usevolt/esb/doc/ce_mark.pdf

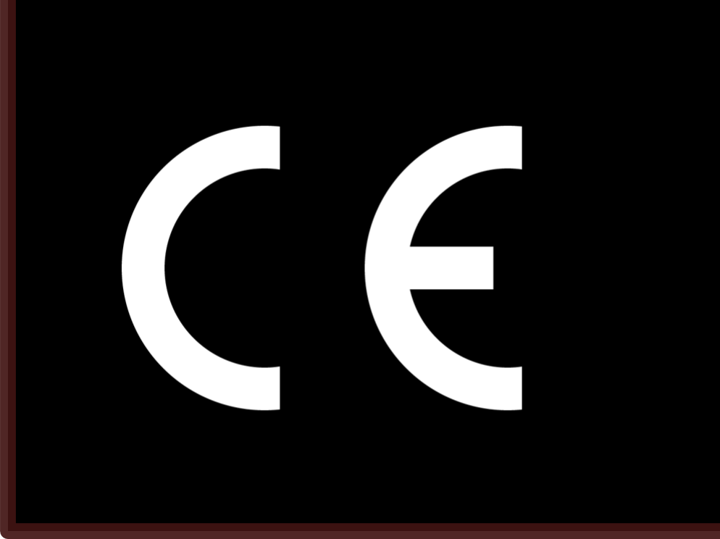
[picture p1: figure]
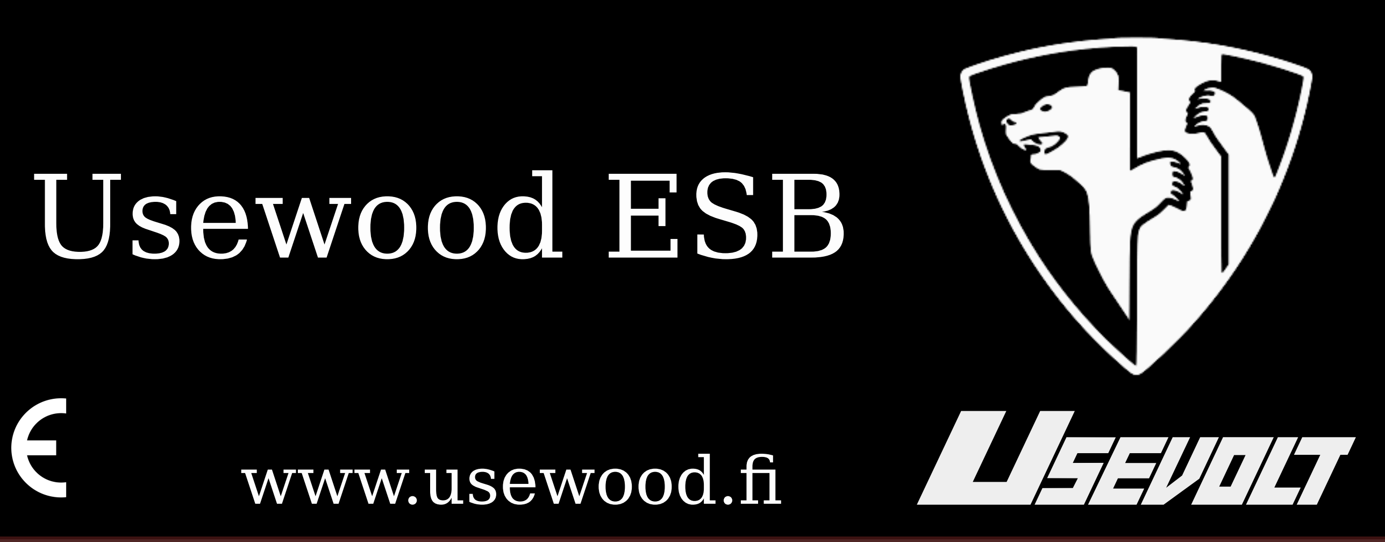
[picture p2: figure]
www.usewood.fi; Usewood ESB
