usevolt/esb/doc/ce_mark_esb_55x20mm.png

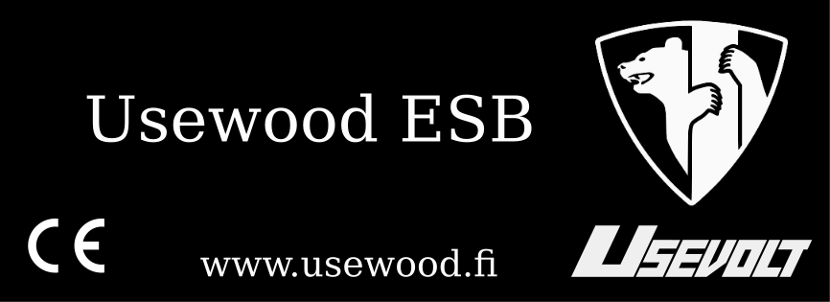
doc/ce_mark_esb_55x20mm.png
