usevolt/esb/hw/esb.FCStd

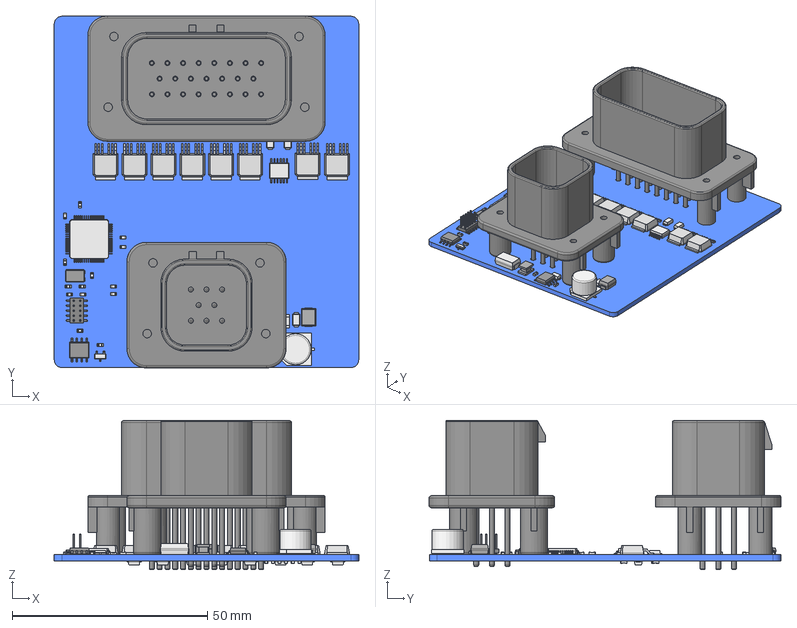
[picture p4: CAD file, 2018-08-07]
hw/esb.FCStd
78.0 x 90.2 x 38.2 mm
Pcb
