usevolt/esb/doc/EDC17CV41_MARINE_C16_CAN_Spec_Feb_2020.pdf

## MARINE

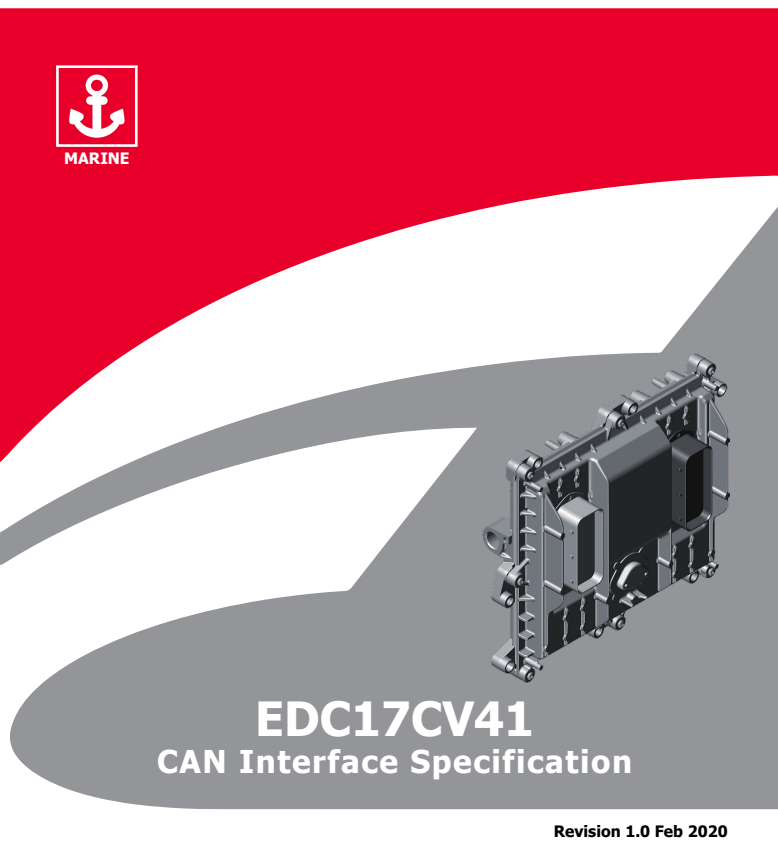
[picture p13: page 1]
Revision 1.0 Feb 2020

EDC17CV41
CAN Interface Specification

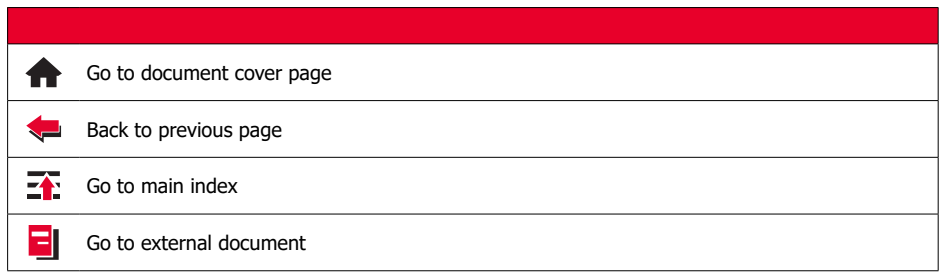
[picture p14: figure]
Go to document cover page; Back to previous page; Go to main index; Go to external document

All Rights Reserved
FPT Confidential and Proprietary Controlled copy is located on fptindustrial.com

B CAN Interface Specification

EDC17CV41
Revision 1.0 Feb 2020

## REVISION HISTORY Document updating

Modification description | Date
First release | Feb 2020

## FPT internal document reference Revision 2.2

Rev | Date | Description | Authors | Approval
2.2 | 11/12/2019 | Modified Document Name EAC Auxiliary/ water system pressure added for C16 | M. Brunello | A. Mazzurco

## INTRODUCTION

## Symbols Reference

## Legend

Signals compliant with SAE which are “not used” or “not evaluated”. Signals in the proprietary messages which are “not used” or “not evaluated”.
“h” hexadecimal values.
“b” binary values.
NB: Value of signals in the messages that are “not used” or “not evaluated” could be not specified.

## REFERENCES

All data is subject to change without notice.

## INDEX

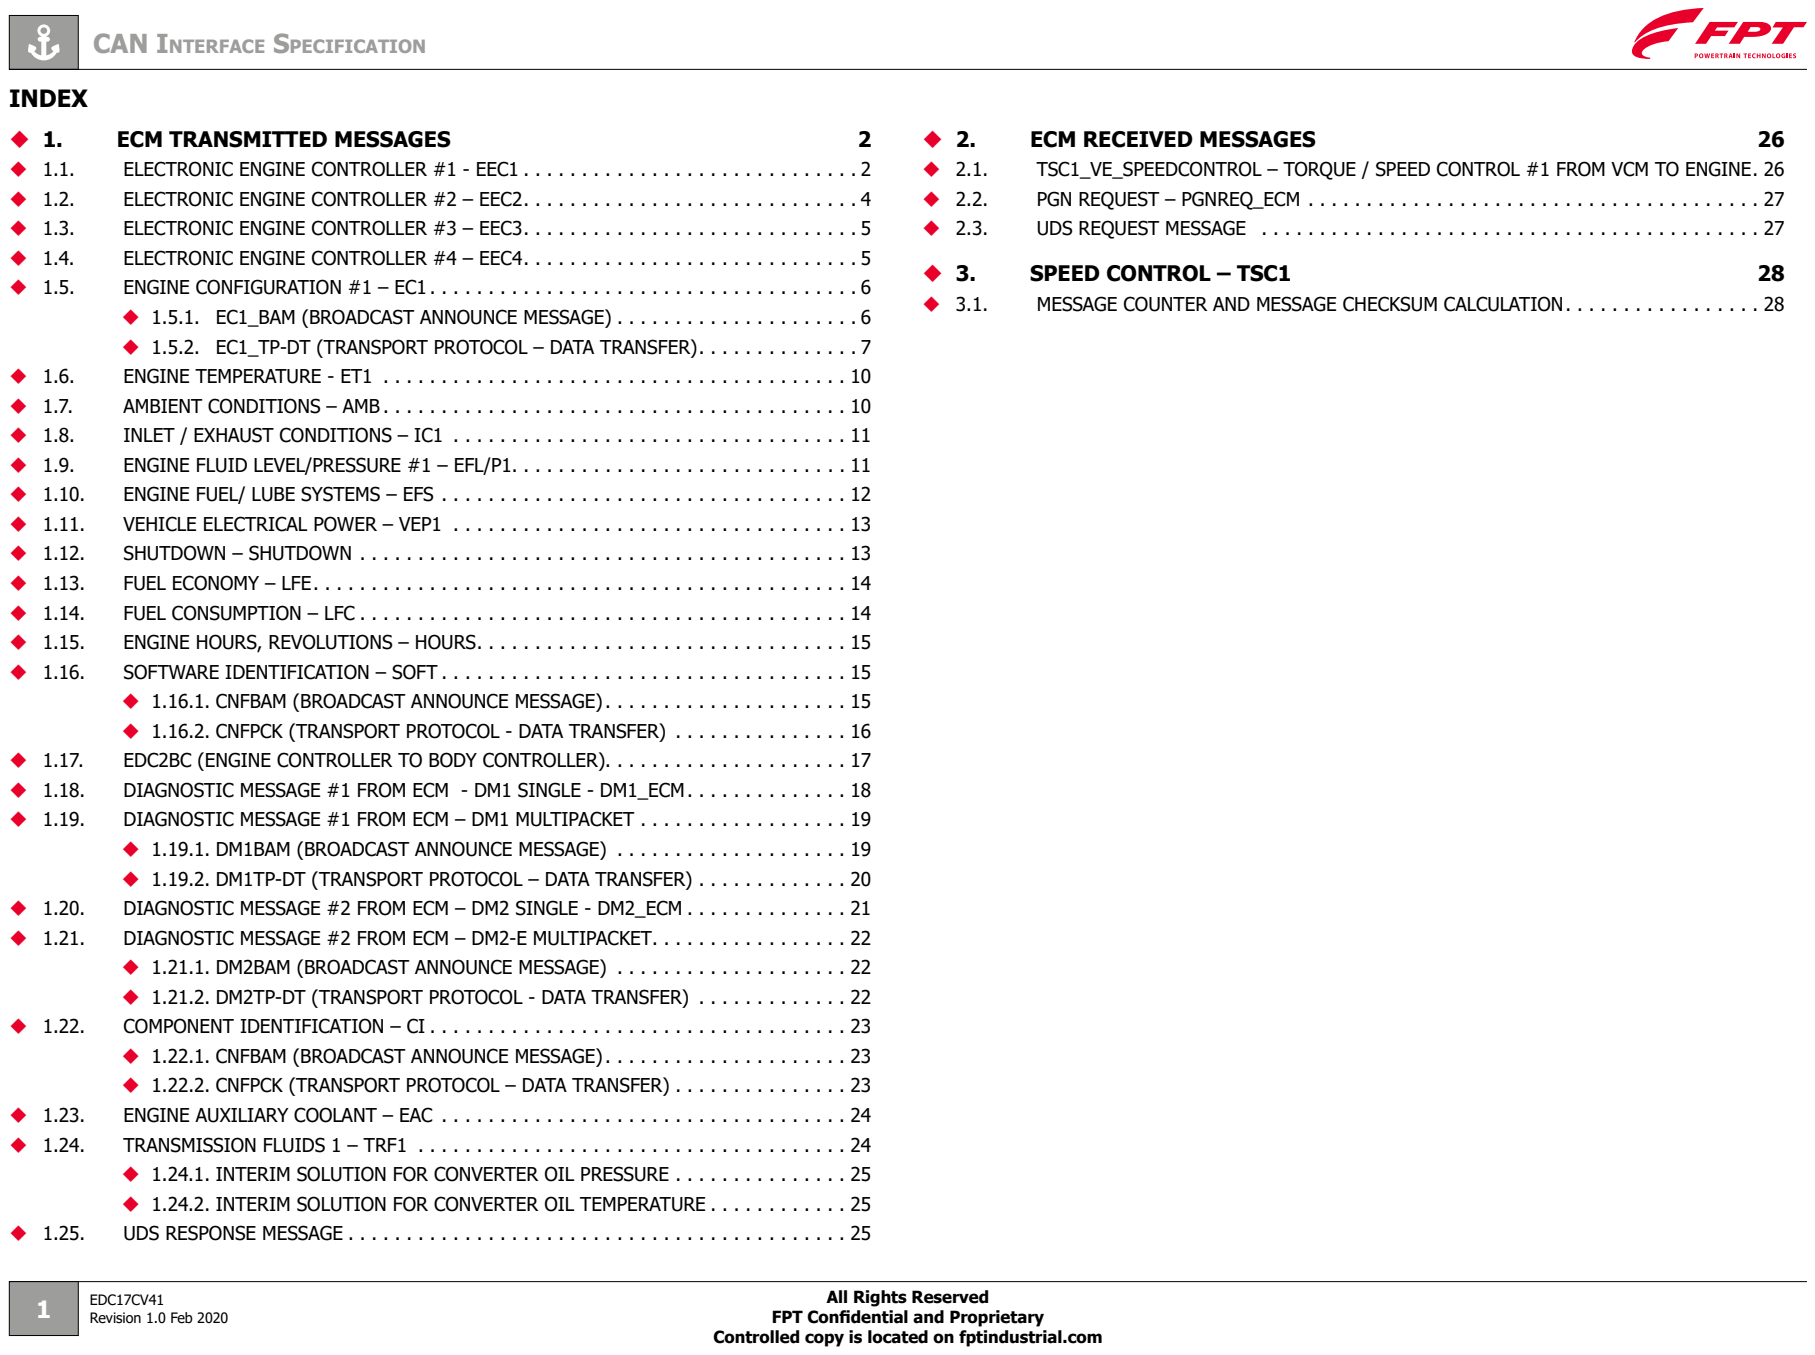
[picture p15: page 3]
ECM TRANSMITTED MESSAGES; ECM RECEIVED MESSAGES; TSC1_VE_SPEEDCONTROL – TORQUE / SPEED CONTROL #1 FROM VCM TO ENGINE.; SPEED CONTROL – TSC1

CAN Interface Specification

## 1. ECM TRANSMITTED MESSAGES

## 1.1. Electronic Engine Controller #1 - EEC1

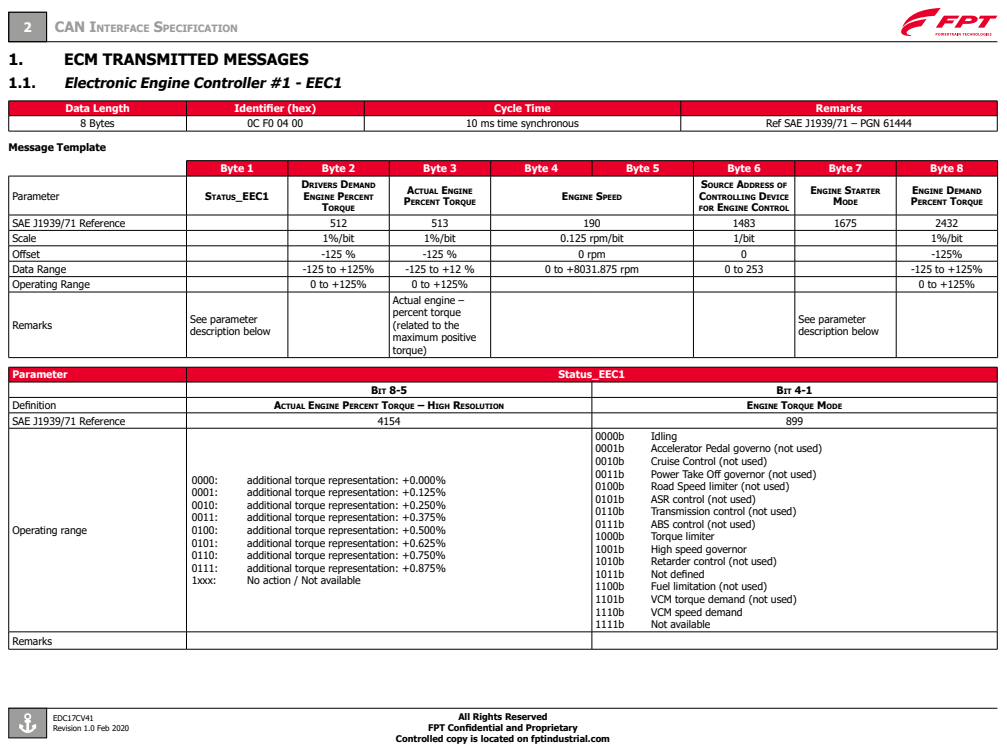
[picture p16: page 4]
Message Template

2 CAN Interface Specification

Data Length | Identifier (hex) | Cycle Time | Remarks
8 Bytes | 0C F0 04 00 | 10 ms time synchronous | Ref SAE J1939/71 – PGN 61444

Byte 1 | Byte 2 | Byte 3 | Byte 4 | Byte 5 | Byte 6 | Byte 7 | Byte 8

Parameter | Status_EEC1 | Drivers Demand Engine Percent Torque | Actual Engine Percent Torque | Engine Speed | Source Address of Controlling Device for Engine Control | Engine Starter Mode | Engine Demand Percent Torque

SAE J1939/71 Reference | | 512 | 513 | 190 | 1483 | 1675 | 2432
Scale | | 1%/bit | 1%/bit | 0.125 rpm/bit | 1/bit | | 1%/bit
Offset | | -125 % | -125 % | 0 rpm | 0 | | -125%
Data Range | | -125 to +125% | -125 to +12 % | 0 to +8031.875 rpm | 0 to 253 | | -125 to +125%
Operating Range | | 0 to +125% | 0 to +125% | | | | 0 to +125%
Remarks | See parameter description below | | Actual engine – percent torque (related to the maximum positive torque) | | | See parameter description below

Parameter | Status_EEC1

Bit 8-5 | Bit 4-1

Definition | Actual Engine Percent Torque – High Resolution | Engine Torque Mode
SAE J1939/71 Reference | 4154 | 899
Operating range | 0000: additional torque representation: +0.000% 0001: additional torque representation: +0.125% 0010: additional torque representation: +0.250% 0011: additional torque representation: +0.375% 0100: additional torque representation: +0.500% 0101: additional torque representation: +0.625% 0110: additional torque representation: +0.750% 0111: additional torque representation: +0.875% 1xxx: No action / Not available | 0000b Idling 0001b Accelerator Pedal governo (not used) 0010b Cruise Control (not used) 0011b Power Take Off governor (not used) 0100b Road Speed limiter (not used) 0101b ASR control (not used) 0110b Transmission control (not used) 0111b ABS control (not used) 1000b Torque limiter 1001b High speed governor 1010b Retarder control (not used) 1011b Not defined 1100b Fuel limitation (not used) 1101b VCM torque demand (not used) 1110b VCM speed demand 1111b Not available

Remarks

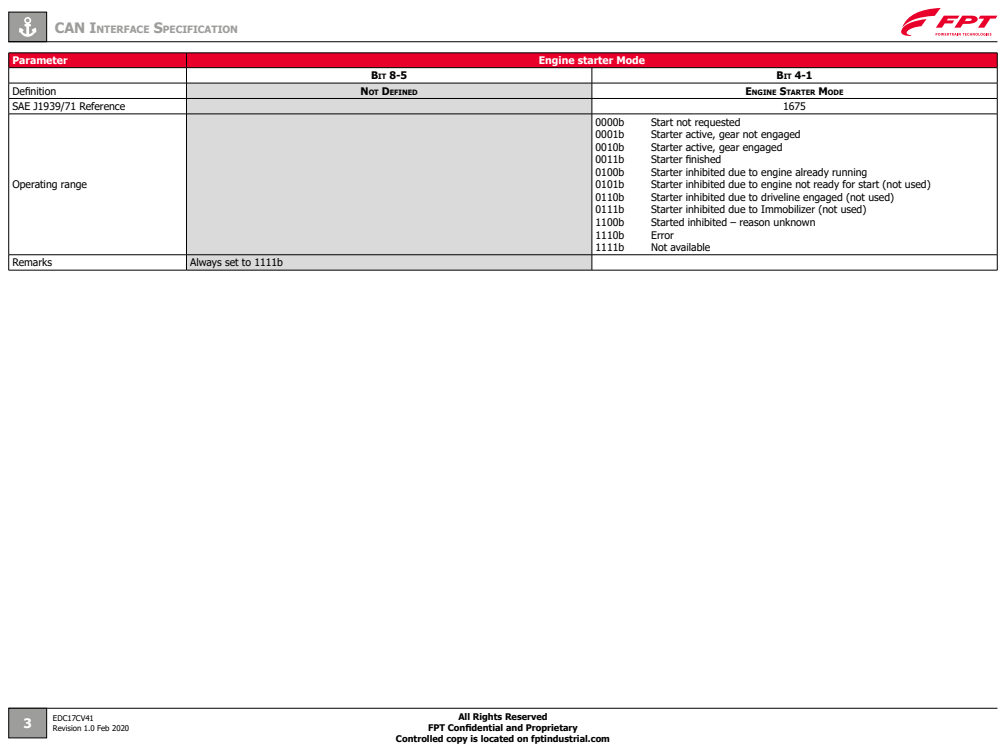
[picture p17: page 5]

Parameter | Engine starter Mode

Bit 8-5 | Bit 4-1

Definition | Not Defined | Engine Starter Mode
SAE J1939/71 Reference | | 1675
Operating range | | 0000b Start not requested 0001b Starter active, gear not engaged 0010b Starter active, gear engaged 0011b Starter finished 0100b Starter inhibited due to engine already running 0101b Starter inhibited due to engine not ready for start (not used) 0110b Starter inhibited due to driveline engaged (not used) 0111b Starter inhibited due to Immobilizer (not used) 1100b Started inhibited – reason unknown 1110b Error 1111b Not available

Remarks | Always set to 1111b

## 1.2. Electronic Engine Controller #2 – EEC2

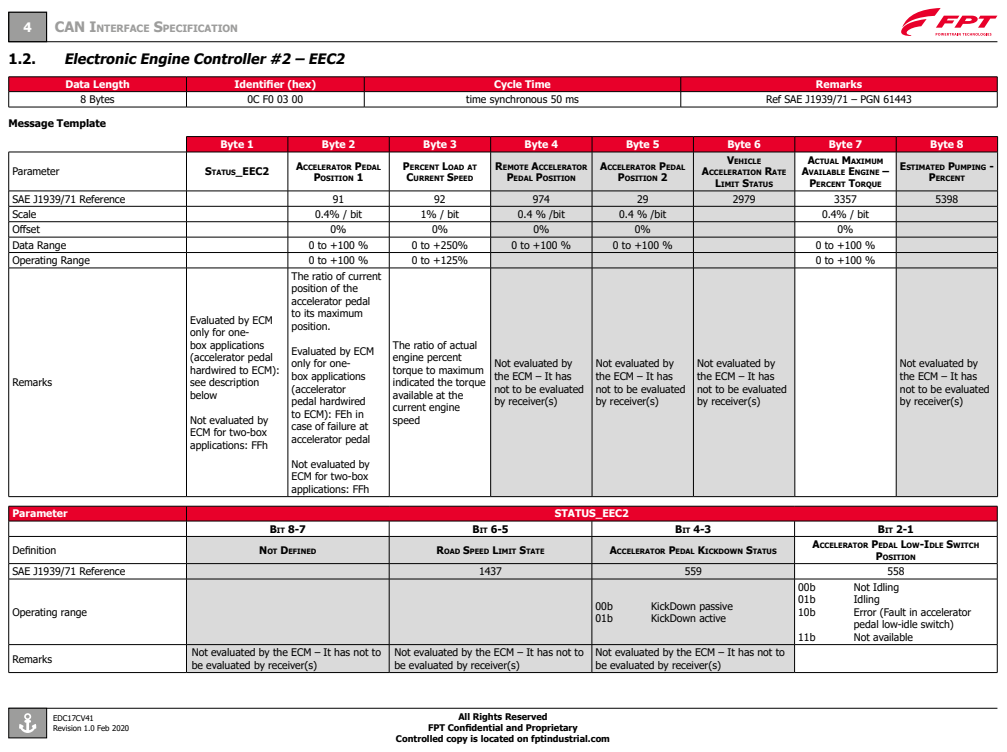
[picture p18: page 6]
Message Template

4 CAN Interface Specification

Data Length | Identifier (hex) | Cycle Time | Remarks
8 Bytes | 0C F0 03 00 | time synchronous 50 ms | Ref SAE J1939/71 – PGN 61443

Byte 1 | Byte 2 | Byte 3 | Byte 4 | Byte 5 | Byte 6 | Byte 7 | Byte 8

Parameter | Status_EEC2 | Accelerator Pedal Position 1 | Percent Load at Current Speed | Remote Accelerator Pedal Position | Accelerator Pedal Position 2 | Vehicle Acceleration Rate Limit Status | Actual Maximum Available Engine – Percent Torque | Estimated Pumping -Percent

SAE J1939/71 Reference | | 91 | 92 | 974 | 29 | 2979 | 3357 | 5398
Scale | | 0.4% / bit | 1% / bit | 0.4 % /bit | 0.4 % /bit | | 0.4% / bit
Offset | | 0% | 0% | 0% | 0% | | 0%
Data Range | | 0 to +100 % | 0 to +250% | 0 to +100 % | 0 to +100 % | | 0 to +100 %
Operating Range | | 0 to +100 % | 0 to +125% | | | | 0 to +100 %
Remarks | Evaluated by ECM only for one-box applications (accelerator pedal hardwired to ECM): see description below Not evaluated by ECM for two-box applications: FFh | The ratio of current position of the accelerator pedal to its maximum position. Evaluated by ECM only for one-box applications (accelerator pedal hardwired to ECM): FEh in case of failure at accelerator pedal Not evaluated by ECM for two-box applications: FFh | The ratio of actual engine percent torque to maximum indicated the torque available at the current engine speed | Not evaluated by the ECM – It has not to be evaluated by receiver(s) | Not evaluated by the ECM – It has not to be evaluated by receiver(s) | Not evaluated by the ECM – It has not to be evaluated by receiver(s) | | Not evaluated by the ECM – It has not to be evaluated by receiver(s)

Parameter | STATUS_EEC2

Bit 8-7 | Bit 6-5 | Bit 4-3 | Bit 2-1

Definition | Not Defined | Road Speed Limit State | Accelerator Pedal Kickdown Status | Accelerator Pedal Low-Idle Switch Position
SAE J1939/71 Reference | | 1437 | 559 | 558
Operating range | | | 00b KickDown passive 01b KickDown active | 00b Not Idling 01b Idling 10b Error (Fault in accelerator pedal low-idle switch) 11b Not available

Remarks | Not evaluated by the ECM – It has not to be evaluated by receiver(s) | Not evaluated by the ECM – It has not to be evaluated by receiver(s) | Not evaluated by the ECM – It has not to be evaluated by receiver(s)

## 1.3. Electronic Engine Controller #3 – EEC3

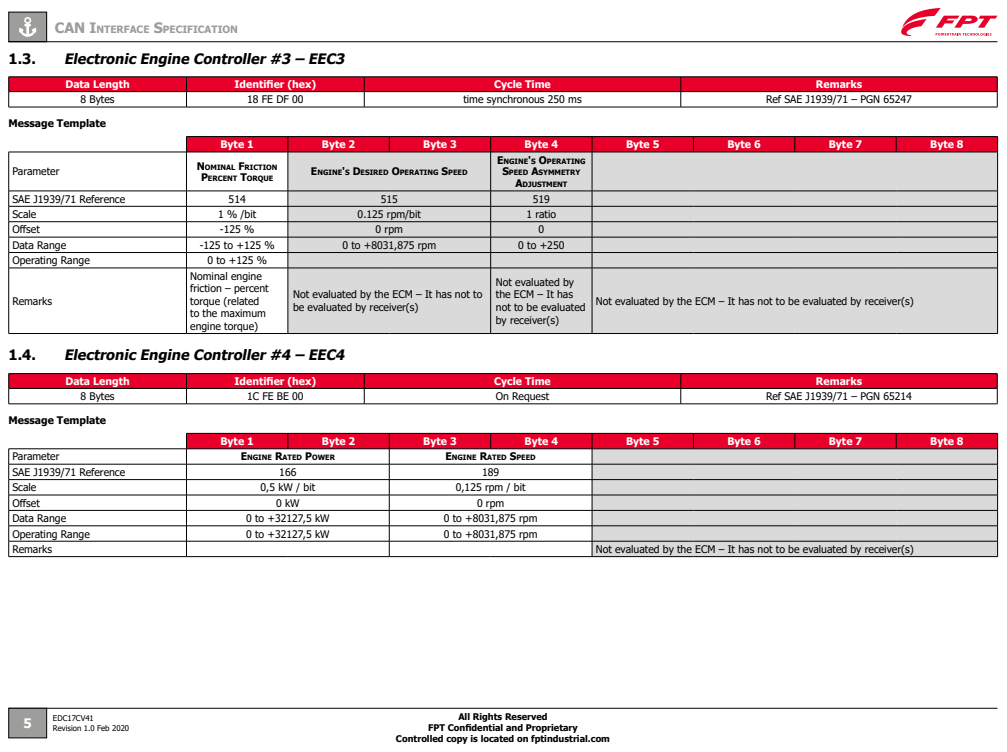
[picture p19: page 7]
Message Template

Data Length | Identifier (hex) | Cycle Time | Remarks
8 Bytes | 18 FE DF 00 | time synchronous 250 ms | Ref SAE J1939/71 – PGN 65247

Byte 1 | Byte 2 | Byte 3 | Byte 4 | Byte 5 | Byte 6 | Byte 7 | Byte 8

Parameter | Nominal Friction Percent Torque | Engine's Desired Operating Speed | Engine's Operating Speed Asymmetry Adjustment

SAE J1939/71 Reference | 514 | 515 | 519
Scale | 1 % /bit | 0.125 rpm/bit | 1 ratio
Offset | -125 % | 0 rpm | 0
Data Range | -125 to +125 % | 0 to +8031,875 rpm | 0 to +250
Operating Range | 0 to +125 %
Remarks | Nominal engine friction – percent torque (related to the maximum engine torque) | Not evaluated by the ECM – It has not to be evaluated by receiver(s) | Not evaluated by the ECM – It has not to be evaluated by receiver(s) | Not evaluated by the ECM – It has not to be evaluated by receiver(s)

1.4. Electronic Engine Controller #4 – EEC4

8 Bytes | 1C FE BE 00 | On Request | Ref SAE J1939/71 – PGN 65214

Parameter | Engine Rated Power | Engine Rated Speed
SAE J1939/71 Reference | 166 | 189
Scale | 0,5 kW / bit | 0,125 rpm / bit
Offset | 0 kW | 0 rpm
Data Range | 0 to +32127,5 kW | 0 to +8031,875 rpm
Operating Range | 0 to +32127,5 kW | 0 to +8031,875 rpm
Remarks | | | Not evaluated by the ECM – It has not to be evaluated by receiver(s)

### 6 CAN Interface Specification

## 1.5. Engine Configuration #1 – EC1

The ECM has to support the Mode 2 for the engine characteristic, according to SAE J1939/71 Surface Vehicle Recommended Practice – Parameter group ENGINE CONFIGURATIon – Mode 2. ENGINE CONFIGURATIon – Mode 2 provides a HIGH IDLE point where torque equals zero and the ENDSPEED GOVERNOR GAIN Kp.
The engine configuration is transmitted as a multi-packet message, consisting of a broadcast announce message and 4 sequential packets with the specified data.

## 1.5.1. EC1_BAM (Broadcast Announce Message)

Data Length | Identifier (hex) | Cycle Time | Remarks
8 Bytes | 18 EC FF 00 | time synchronous 5000 or in the event of a change of speed and/ or torque curves more than ±10% | This message is used to inform all stations on the CAN that a large message is about to be transmitted. After this broadcast message, individual packages can be transmitted

Message Template
Byte 1 | Byte 2 | Byte 3 | Byte 4 | Byte 5 | Byte 6 | Byte 7 | Byte 8
Parameter | Control Byte | Total Message Size, Number of Bytes | Total Number of Packets | Reserved for Assignment by SAE | Parameter Group Number of the Packet Message
Assigned value | 32 | 28 | 4 | FFH | E3FE00H
Remarks

7

## 1.5.2. EC1_TP-DT (Transport Protocol – Data Transfer)

Data Length | Identifier (hex) | Cycle Time | Remarks
8 Bytes | 18 EB FF 00 | time synchronous 5000 or in the event of a change of speed and/or torque curves more than ±10% | This is a multipackage message consisting of 4 packets and the interval between individual messages is 50 ms. A characteristic curve for limiting torque is transmitted, according to SAE J1939/71 Surface Vehicle Recommended Practice – Parameter group ENGINE CONFIGURATIon – Mode 2

Definition

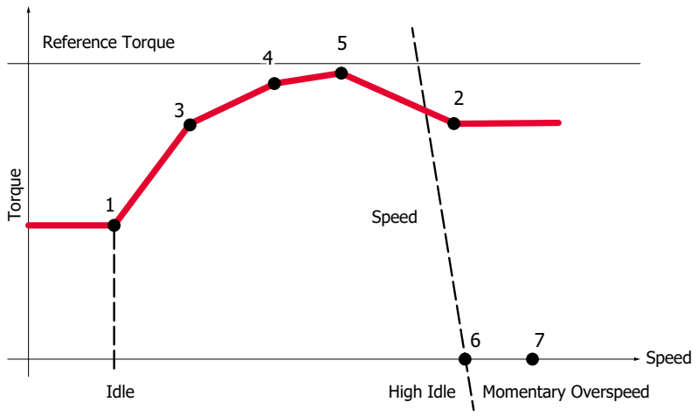
[picture p20: figure]
Reference Torque; High Idle Momentary Overspeed; Torque; Speed; Idle

Point 1 | Torque / speed point at idle, variable
Point 2 | Torque / speed at highest possible engine speed, fixed applicable
Points 3-5 | Torque / speed points between points 1 and 2 to permit linear interpolation over the entire torque range, fixed applicable.
Point 6 | High idle speed (torque = 0) , variable
Point 7 | Maximum momentary engine override speed (torque = 0) , fixed applicable

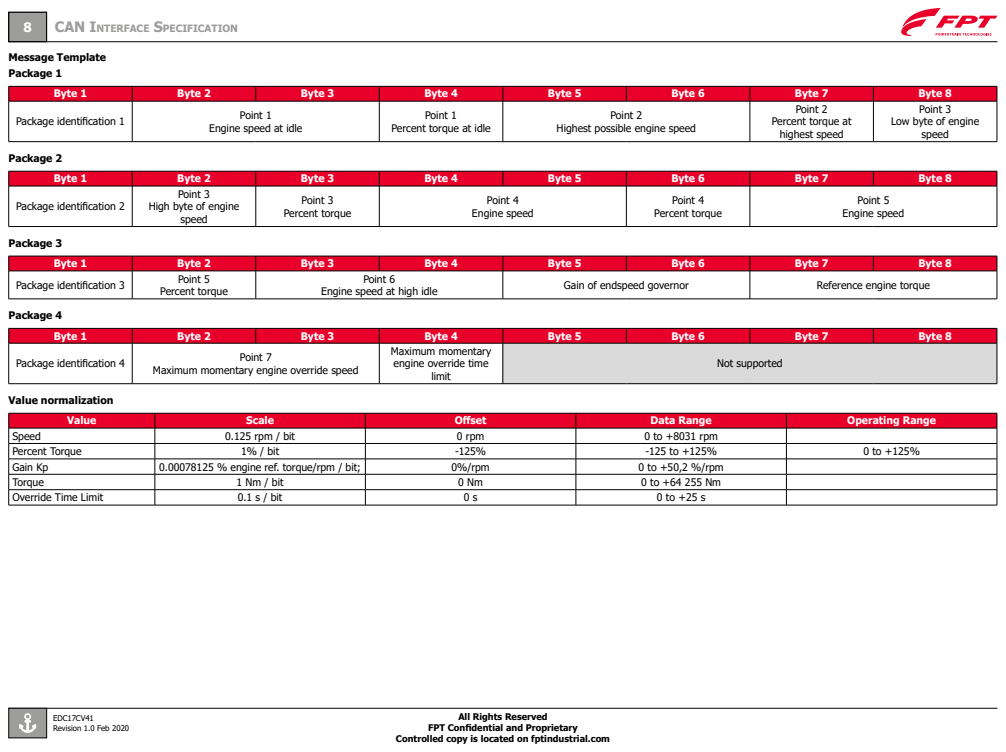
[picture p21: page 10]
Message Template Package 1; Package 2; Package 3; Package 4; Value normalization

8 CAN Interface Specification

Byte 1 | Byte 2 | Byte 3 | Byte 4 | Byte 5 | Byte 6 | Byte 7 | Byte 8
Package identification 1 | Point 1 Engine speed at idle | | Point 1 Percent torque at idle | Point 2 Highest possible engine speed | | Point 2 Percent torque at highest speed | Point 3 Low byte of engine speed

Package identification 2 | Point 3 High byte of engine speed | Point 3 Percent torque | Point 4 Engine speed | | Point 4 Percent torque | Point 5 Engine speed

Package identification 3 | Point 5 Percent torque | Point 6 Engine speed at high idle | | Gain of endspeed governor | | Reference engine torque

Package identification 4 | Point 7 Maximum momentary engine override speed | | Maximum momentary engine override time limit | Not supported

Value | Scale | Offset | Data Range | Operating Range

Speed | 0.125 rpm / bit | 0 rpm | 0 to +8031 rpm
Percent Torque | 1% / bit | -125% | -125 to +125% | 0 to +125%
Gain Kp | 0.00078125 % engine ref. torque/rpm / bit; | 0%/rpm | 0 to +50,2 %/rpm
Torque | 1 Nm / bit | 0 Nm | 0 to +64 255 Nm
Override Time Limit | 0.1 s / bit | 0 s | 0 to +25 s

9

Conditions of maximum torque curve reduction.
ECM will reduce the maximum torque curve indicated in the Engine configuration message in the following conditions:
Type of torque limitation | Remarks
Engine overheat protection
Atmospheric pressure correction
System degradation
Conditions of low idle increase.
The low idle setpoint, actuated and indicated as point 1 of the Engine Configuration message, can be increased by one of the following events (the max value is selected):
Event for low idle increase | Remarks
Low engine temperature
Low battery voltage
Conditions of high idle decrease.
The high idle setpoint, actuated and indicated as point 6 of the Engine Configuration message, can be increased by one of the following events (the min value is selected):
Event for high idle decrease | Remarks
System degradation
Low engine temperature after start
Reference speed setpoints calculation.
Speed Point in ENG_CONF | Calculation
Point 1 | Current low idle speed (dynamic calculation)
Point 2 | Application value (static)
Point 3 | Application value (static)
Point 4 | Application value (static)
Point 5 | Application value (static)
Point 6 | Current high idle speed (dynamic calculation)
Point 7 | Application value (static)
Gain of endspeed governor | Current endspeed feedback factor (dynamic calculation)

## 1.6. Engine Temperature - ET1

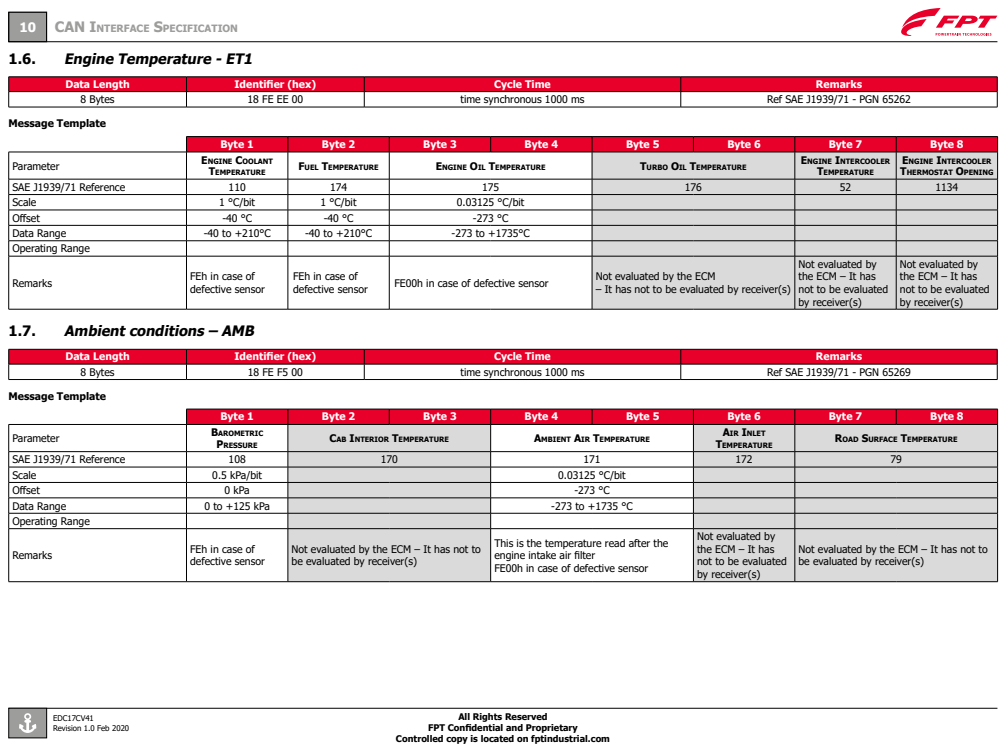
[picture p22: page 12]
Message Template

10 CAN Interface Specification

Data Length | Identifier (hex) | Cycle Time | Remarks
8 Bytes | 18 FE EE 00 | time synchronous 1000 ms | Ref SAE J1939/71 - PGN 65262

Byte 1 | Byte 2 | Byte 3 | Byte 4 | Byte 5 | Byte 6 | Byte 7 | Byte 8

Parameter | Engine Coolant Temperature | Fuel Temperature | Engine Oil Temperature | Turbo Oil Temperature | Engine Intercooler Temperature | Engine Intercooler Thermostat Opening
SAE J1939/71 Reference | 110 | 174 | 175 | 176 | 52 | 1134
Scale | 1 °C/bit | 1 °C/bit | 0.03125 °C/bit
Offset | -40 °C | -40 °C | -273 °C
Data Range | -40 to +210°C | -40 to +210°C | -273 to +1735°C
Operating Range
Remarks | FEh in case of defective sensor | FEh in case of defective sensor | FE00h in case of defective sensor | Not evaluated by the ECM – It has not to be evaluated by receiver(s) | Not evaluated by the ECM – It has not to be evaluated by receiver(s) | Not evaluated by the ECM – It has not to be evaluated by receiver(s)

1.7. Ambient conditions – AMB

8 Bytes | 18 FE F5 00 | time synchronous 1000 ms | Ref SAE J1939/71 - PGN 65269

Parameter | Barometric Pressure | Cab Interior Temperature | Ambient Air Temperature | Air Inlet Temperature | Road Surface Temperature
SAE J1939/71 Reference | 108 | 170 | 171 | 172 | 79
Scale | 0.5 kPa/bit | | 0.03125 °C/bit
Offset | 0 kPa | | -273 °C
Data Range | 0 to +125 kPa | | -273 to +1735 °C
Remarks | FEh in case of defective sensor | Not evaluated by the ECM – It has not to be evaluated by receiver(s) | This is the temperature read after the engine intake air filter FE00h in case of defective sensor | Not evaluated by the ECM – It has not to be evaluated by receiver(s) | Not evaluated by the ECM – It has not to be evaluated by receiver(s)

## 1.8. Inlet / Exhaust Conditions – IC1

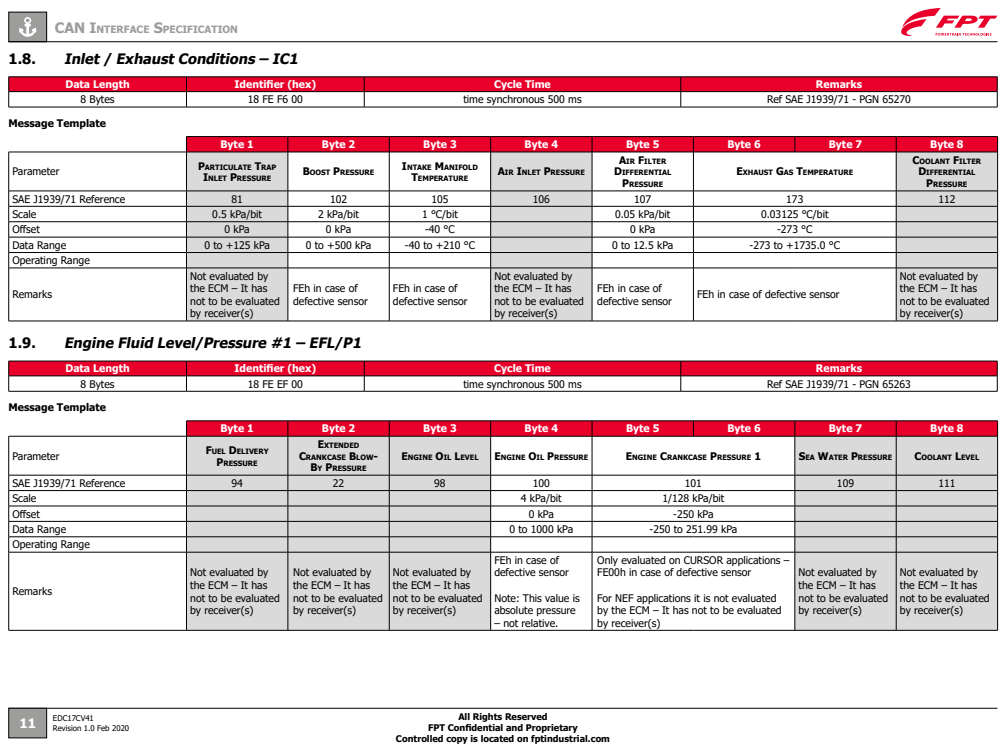
[picture p23: page 13]
Message Template

Data Length | Identifier (hex) | Cycle Time | Remarks
8 Bytes | 18 FE F6 00 | time synchronous 500 ms | Ref SAE J1939/71 - PGN 65270

Byte 1 | Byte 2 | Byte 3 | Byte 4 | Byte 5 | Byte 6 | Byte 7 | Byte 8

Parameter | Particulate Trap Inlet Pressure | Boost Pressure | Intake Manifold Temperature | Air Inlet Pressure | Air Filter Differential Pressure | Exhaust Gas Temperature | Coolant Filter Differential Pressure

SAE J1939/71 Reference | 81 | 102 | 105 | 106 | 107 | 173 | 112
Scale | 0.5 kPa/bit | 2 kPa/bit | 1 °C/bit | | 0.05 kPa/bit | 0.03125 °C/bit
Offset | 0 kPa | 0 kPa | -40 °C | | 0 kPa | -273 °C
Data Range | 0 to +125 kPa | 0 to +500 kPa | -40 to +210 °C | | 0 to 12.5 kPa | -273 to +1735.0 °C
Operating Range
Remarks | Not evaluated by the ECM – It has not to be evaluated by receiver(s) | FEh in case of defective sensor | FEh in case of defective sensor | Not evaluated by the ECM – It has not to be evaluated by receiver(s) | FEh in case of defective sensor | FEh in case of defective sensor | Not evaluated by the ECM – It has not to be evaluated by receiver(s)

1.9. Engine Fluid Level/Pressure #1 – EFL/P1

8 Bytes | 18 FE EF 00 | time synchronous 500 ms | Ref SAE J1939/71 - PGN 65263

Parameter | Fuel Delivery Pressure | Extended Crankcase Blow-By Pressure | Engine Oil Level | Engine Oil Pressure | Engine Crankcase Pressure 1 | Sea Water Pressure | Coolant Level

SAE J1939/71 Reference | 94 | 22 | 98 | 100 | 101 | 109 | 111
Scale | | | | 4 kPa/bit | 1/128 kPa/bit
Offset | | | | 0 kPa | -250 kPa
Data Range | | | | 0 to 1000 kPa | -250 to 251.99 kPa
Remarks | Not evaluated by the ECM – It has not to be evaluated by receiver(s) | Not evaluated by the ECM – It has not to be evaluated by receiver(s) | Not evaluated by the ECM – It has not to be evaluated by receiver(s) | FEh in case of defective sensor Note: This value is absolute pressure – not relative. | Only evaluated on CURSOR applications – FE00h in case of defective sensor For NEF applications it is not evaluated by the ECM – It has not to be evaluated by receiver(s) | Not evaluated by the ECM – It has not to be evaluated by receiver(s) | Not evaluated by the ECM – It has not to be evaluated by receiver(s)

## 1.10. Engine Fuel/ Lube Systems – EFS

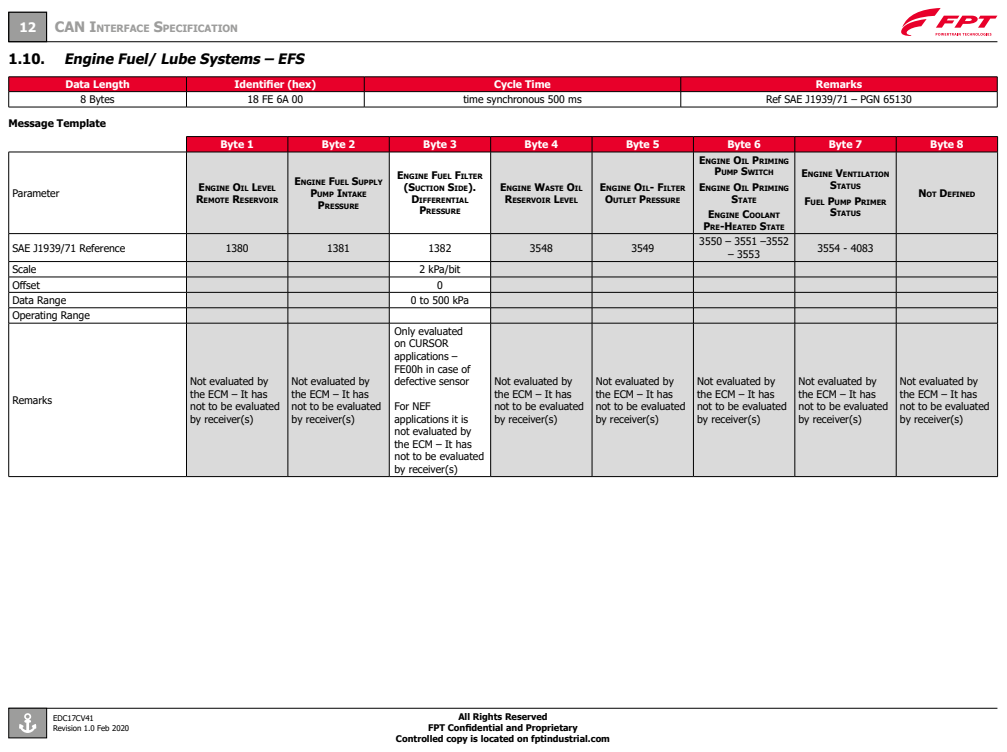
[picture p24: page 14]
Message Template

12 CAN Interface Specification

Data Length | Identifier (hex) | Cycle Time | Remarks
8 Bytes | 18 FE 6A 00 | time synchronous 500 ms | Ref SAE J1939/71 – PGN 65130

Byte 1 | Byte 2 | Byte 3 | Byte 4 | Byte 5 | Byte 6 | Byte 7 | Byte 8

Parameter | Engine Oil Level Remote Reservoir | Engine Fuel Supply Pump Intake Pressure | Engine Fuel Filter (Suction Side). Differential Pressure | Engine Waste Oil Reservoir Level | Engine Oil- Filter Outlet Pressure | Engine Oil Priming Pump Switch Engine Oil Priming State Engine Coolant Pre-Heated State | Engine Ventilation Status Fuel Pump Primer Status | Not Defined

SAE J1939/71 Reference | 1380 | 1381 | 1382 | 3548 | 3549 | 3550 – 3551 –3552 – 3553 | 3554 - 4083
Scale | | | 2 kPa/bit
Offset | | | 0
Data Range | | | 0 to 500 kPa
Operating Range
Remarks | Not evaluated by the ECM – It has not to be evaluated by receiver(s) | Not evaluated by the ECM – It has not to be evaluated by receiver(s) | Only evaluated on CURSOR applications – FE00h in case of defective sensor For NEF applications it is not evaluated by the ECM – It has not to be evaluated by receiver(s) | Not evaluated by the ECM – It has not to be evaluated by receiver(s) | Not evaluated by the ECM – It has not to be evaluated by receiver(s) | Not evaluated by the ECM – It has not to be evaluated by receiver(s) | Not evaluated by the ECM – It has not to be evaluated by receiver(s) | Not evaluated by the ECM – It has not to be evaluated by receiver(s)

## 1.11. Vehicle Electrical Power – VEP1

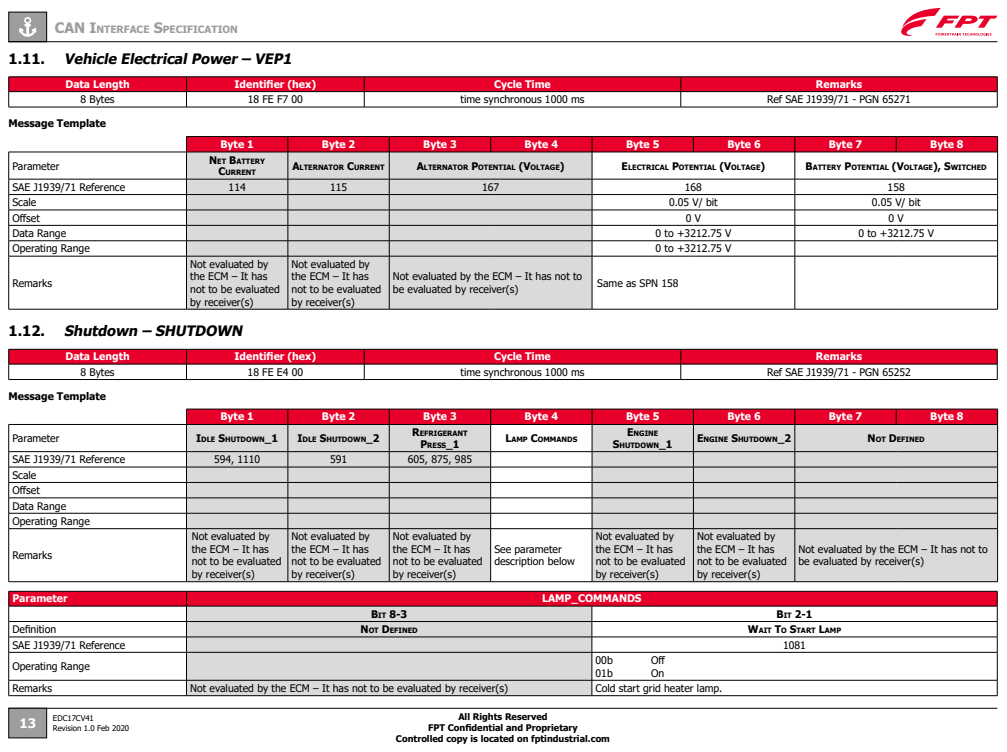
[picture p25: page 15]
Message Template; 1.12. Shutdown – SHUTDOWN

Data Length | Identifier (hex) | Cycle Time | Remarks
8 Bytes | 18 FE F7 00 | time synchronous 1000 ms | Ref SAE J1939/71 - PGN 65271

Byte 1 | Byte 2 | Byte 3 | Byte 4 | Byte 5 | Byte 6 | Byte 7 | Byte 8

Parameter | Net Battery Current | Alternator Current | Alternator Potential (Voltage) | Electrical Potential (Voltage) | Battery Potential (Voltage), Switched
SAE J1939/71 Reference | 114 | 115 | 167 | 168 | 158
Scale | | | | 0.05 V/ bit | 0.05 V/ bit
Offset | | | | 0 V | 0 V
Data Range | | | | 0 to +3212.75 V | 0 to +3212.75 V
Operating Range | | | | 0 to +3212.75 V
Remarks | Not evaluated by the ECM – It has not to be evaluated by receiver(s) | Not evaluated by the ECM – It has not to be evaluated by receiver(s) | Not evaluated by the ECM – It has not to be evaluated by receiver(s) | Same as SPN 158

8 Bytes | 18 FE E4 00 | time synchronous 1000 ms | Ref SAE J1939/71 - PGN 65252

Parameter | Idle Shutdown_1 | Idle Shutdown_2 | Refrigerant Press_1 | Lamp Commands | Shutdown_1 Engine | Engine Shutdown_2 | Not Defined
SAE J1939/71 Reference | 594, 1110 | 591 | 605, 875, 985
Scale
Offset
Data Range
Operating Range
Remarks | Not evaluated by the ECM – It has not to be evaluated by receiver(s) | Not evaluated by the ECM – It has not to be evaluated by receiver(s) | Not evaluated by the ECM – It has not to be evaluated by receiver(s) | See parameter description below | Not evaluated by the ECM – It has not to be evaluated by receiver(s) | Not evaluated by the ECM – It has not to be evaluated by receiver(s) | Not evaluated by the ECM – It has not to be evaluated by receiver(s)

Parameter | LAMP_COMMANDS

Bit 8-3 | Bit 2-1

Definition | Not Defined | Wait To Start Lamp
SAE J1939/71 Reference | | 1081
Operating Range | | 00b Off 01b On
Remarks | Not evaluated by the ECM – It has not to be evaluated by receiver(s) | Cold start grid heater lamp.

## 1.13. Fuel Economy – LFE

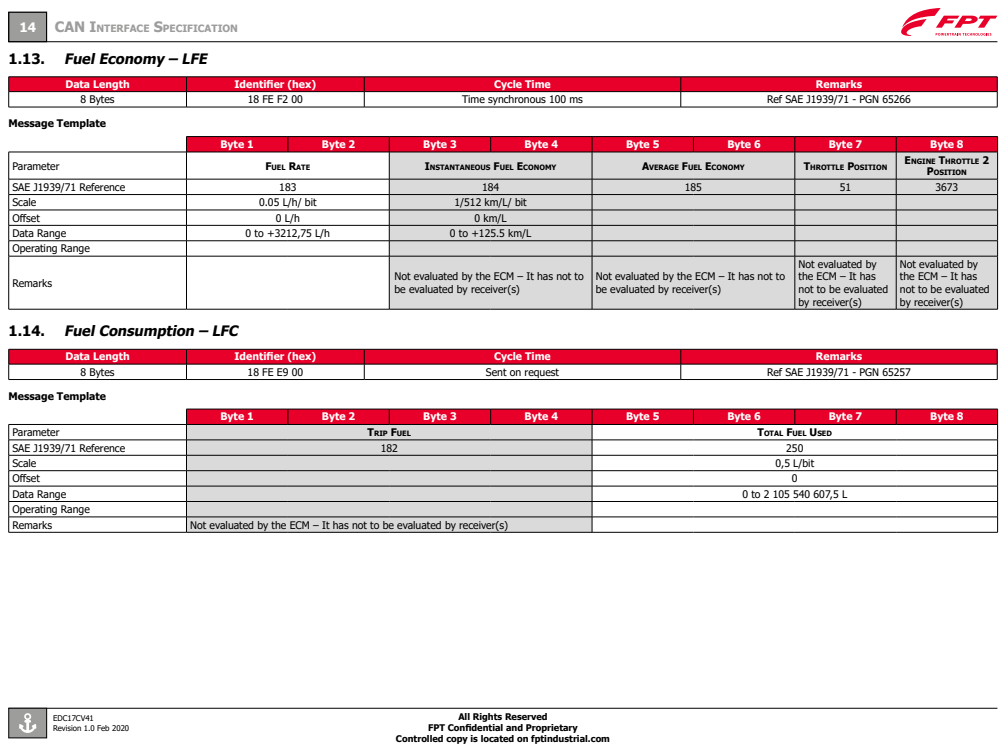
[picture p26: page 16]
Message Template

14 CAN Interface Specification

Data Length | Identifier (hex) | Cycle Time | Remarks
8 Bytes | 18 FE F2 00 | Time synchronous 100 ms | Ref SAE J1939/71 - PGN 65266

Byte 1 | Byte 2 | Byte 3 | Byte 4 | Byte 5 | Byte 6 | Byte 7 | Byte 8

Parameter | Fuel Rate | Instantaneous Fuel Economy | Average Fuel Economy | Throttle Position | Engine Throttle 2 Position
SAE J1939/71 Reference | 183 | 184 | 185 | 51 | 3673
Scale | 0.05 L/h/ bit | 1/512 km/L/ bit
Offset | 0 L/h | 0 km/L
Data Range | 0 to +3212,75 L/h | 0 to +125.5 km/L
Operating Range
Remarks | | Not evaluated by the ECM – It has not to be evaluated by receiver(s) | Not evaluated by the ECM – It has not to be evaluated by receiver(s) | Not evaluated by the ECM – It has not to be evaluated by receiver(s) | Not evaluated by the ECM – It has not to be evaluated by receiver(s)

1.14. Fuel Consumption – LFC

8 Bytes | 18 FE E9 00 | Sent on request | Ref SAE J1939/71 - PGN 65257

Parameter | Trip Fuel | Total Fuel Used
SAE J1939/71 Reference | 182 | 250
Scale | | 0,5 L/bit
Offset | | 0
Data Range | | 0 to 2 105 540 607,5 L
Remarks | Not evaluated by the ECM – It has not to be evaluated by receiver(s)

## 1.15. Engine Hours, Revolutions – HOURS

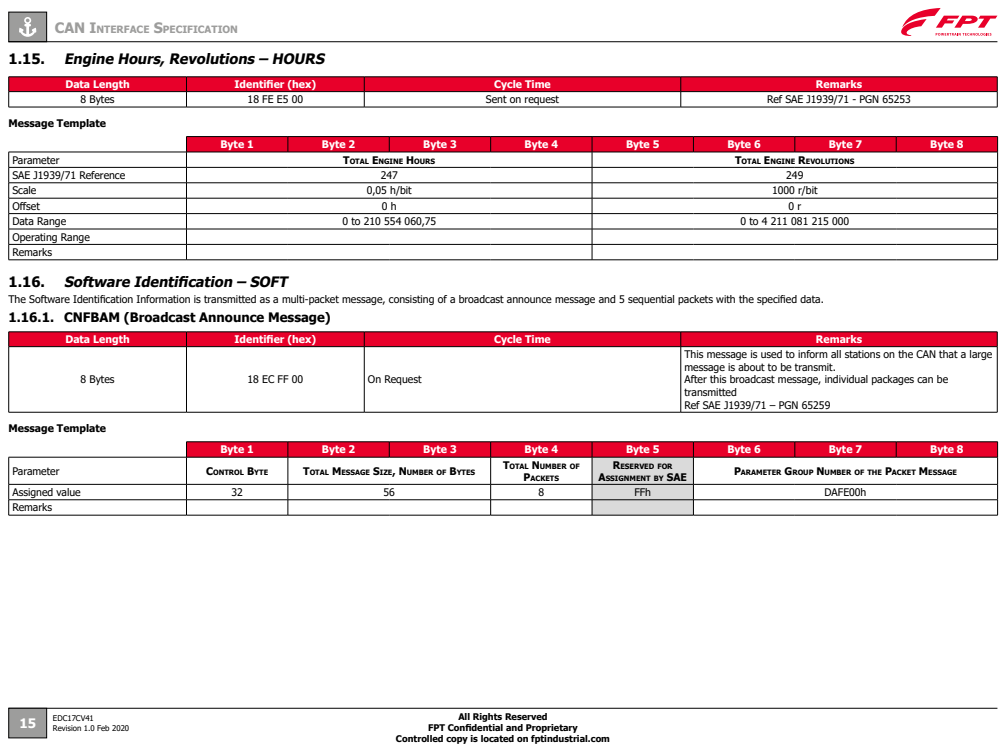
[picture p27: page 17]
Message Template

Data Length | Identifier (hex) | Cycle Time | Remarks
8 Bytes | 18 FE E5 00 | Sent on request | Ref SAE J1939/71 - PGN 65253

Byte 1 | Byte 2 | Byte 3 | Byte 4 | Byte 5 | Byte 6 | Byte 7 | Byte 8

Parameter | Total Engine Hours | Total Engine Revolutions
SAE J1939/71 Reference | 247 | 249
Scale | 0,05 h/bit | 1000 r/bit
Offset | 0 h | 0 r
Data Range | 0 to 210 554 060,75 | 0 to 4 211 081 215 000
Operating Range
Remarks

1.16. Software Identification – SOFT
The Software Identification Information is transmitted as a multi-packet message, consisting of a broadcast announce message and 5 sequential packets with the specified data.
1.16.1. CNFBAM (Broadcast Announce Message)

8 Bytes | 18 EC FF 00 | On Request | This message is used to inform all stations on the CAN that a large message is about to be transmit. After this broadcast message, individual packages can be transmitted Ref SAE J1939/71 – PGN 65259

Parameter | Control Byte | Total Message Size, Number of Bytes | Total Number of Packets | Reserved for Assignment by SAE | Parameter Group Number of the Packet Message
Assigned value | 32 | 56 | 8 | FFh | DAFE00h

## 1.16.2. CNFPCK (Transport Protocol - Data Transfer)

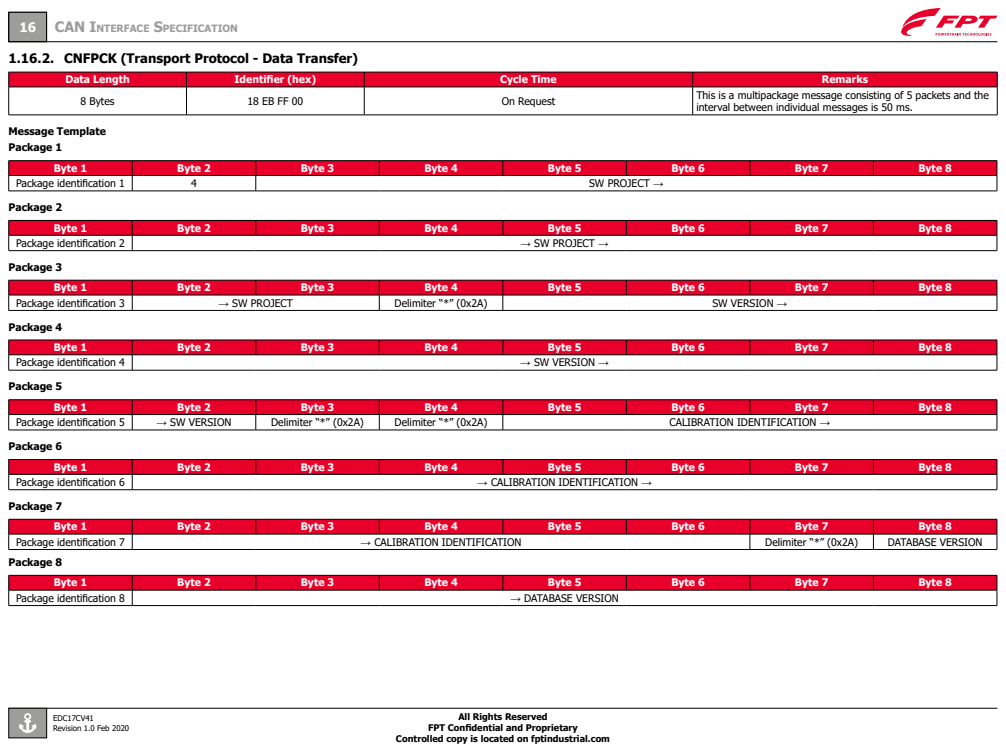
[picture p28: page 18]
Message Template Package 1; Package 2; Package 3; Package 4; Package 5; Package 6; Package 7; Package 8

16 CAN Interface Specification

Data Length | Identifier (hex) | Cycle Time | Remarks
8 Bytes | 18 EB FF 00 | On Request | This is a multipackage message consisting of 5 packets and the interval between individual messages is 50 ms.

Byte 1 | Byte 2 | Byte 3 | Byte 4 | Byte 5 | Byte 6 | Byte 7 | Byte 8
Package identification 1 | 4 | SW PROJECT →

Package identification 2 | → SW PROJECT →

Package identification 3 | → SW PROJECT | | Delimiter “*” (0x2A) | SW VERSION →

Package identification 4 | → SW VERSION →

Package identification 5 | → SW VERSION | Delimiter “*” (0x2A) | Delimiter “*” (0x2A) | CALIBRATION IDENTIFICATION →

Package identification 6 | → CALIBRATION IDENTIFICATION →

Package identification 7 | → CALIBRATION IDENTIFICATION | | | | | Delimiter “*” (0x2A) | DATABASE VERSION

Package identification 8 | → DATABASE VERSION

## 1.17. EDC2BC (Engine Controller to Body controller)

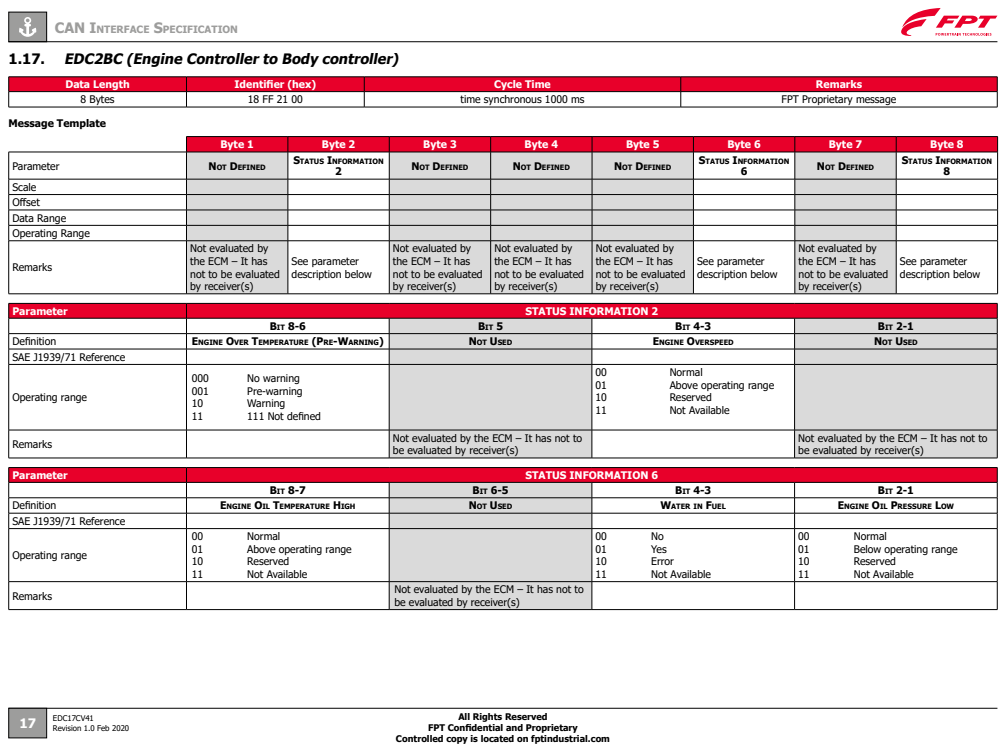
[picture p29: page 19]
Message Template

Data Length | Identifier (hex) | Cycle Time | Remarks
8 Bytes | 18 FF 21 00 | time synchronous 1000 ms | FPT Proprietary message

Byte 1 | Byte 2 | Byte 3 | Byte 4 | Byte 5 | Byte 6 | Byte 7 | Byte 8

Parameter | Not Defined | Status Information 2 | Not Defined | Not Defined | Not Defined | Status Information 6 | Not Defined | Status Information 8
Scale
Offset
Data Range
Operating Range
Remarks | Not evaluated by the ECM – It has not to be evaluated by receiver(s) | See parameter description below | Not evaluated by the ECM – It has not to be evaluated by receiver(s) | Not evaluated by the ECM – It has not to be evaluated by receiver(s) | Not evaluated by the ECM – It has not to be evaluated by receiver(s) | See parameter description below | Not evaluated by the ECM – It has not to be evaluated by receiver(s) | See parameter description below

Parameter | STATUS INFORMATION 2

Bit 8-6 | Bit 5 | Bit 4-3 | Bit 2-1

Definition | Engine Over Temperature (Pre-Warning) | Not Used | Engine Overspeed | Not Used
SAE J1939/71 Reference
Operating range | 000 No warning 001 Pre-warning 10 Warning 11 111 Not defined | | 00 Normal 01 Above operating range 10 Reserved 11 Not Available

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

Parameter | STATUS INFORMATION 6

Bit 8-7 | Bit 6-5 | Bit 4-3 | Bit 2-1

Definition | Engine Oil Temperature High | Not Used | Water in Fuel | Engine Oil Pressure Low
Operating range | 00 Normal 01 Above operating range 10 Reserved 11 Not Available | | 00 No 01 Yes 10 Error 11 Not Available | 00 Normal 01 Below operating range 10 Reserved 11 Not Available

Remarks | | Not evaluated by the ECM – It has not to be evaluated by receiver(s)

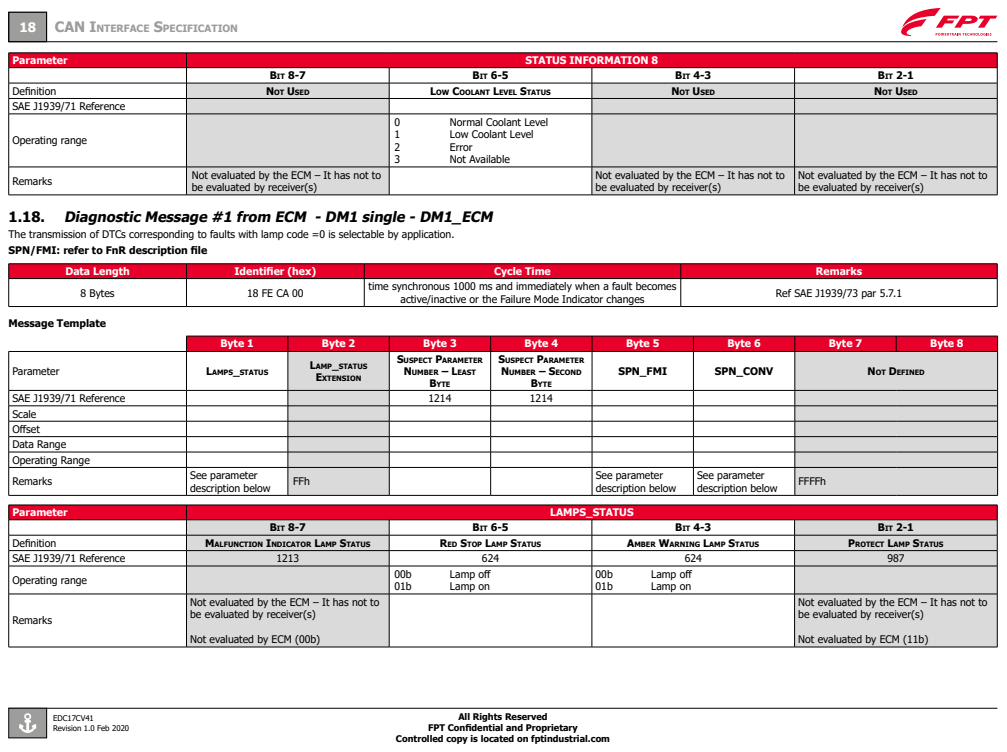
[picture p30: page 20]
Message Template

18 CAN Interface Specification

Parameter | STATUS INFORMATION 8

Bit 8-7 | Bit 6-5 | Bit 4-3 | Bit 2-1

Definition | Not Used | Low Coolant Level Status | Not Used | Not Used
SAE J1939/71 Reference
Operating range | | 0 Normal Coolant Level 1 Low Coolant Level 2 Error 3 Not Available

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

1.18. Diagnostic Message #1 from ECM - DM1 single - DM1_ECM
The transmission of DTCs corresponding to faults with lamp code =0 is selectable by application.
SPN/FMI: refer to FnR description file

Data Length | Identifier (hex) | Cycle Time | Remarks
8 Bytes | 18 FE CA 00 | time synchronous 1000 ms and immediately when a fault becomes active/inactive or the Failure Mode Indicator changes | Ref SAE J1939/73 par 5.7.1

Byte 1 | Byte 2 | Byte 3 | Byte 4 | Byte 5 | Byte 6 | Byte 7 | Byte 8

Parameter | Lamps_status | Lamp_status Extension | Suspect Parameter Number – Least Byte | Suspect Parameter Number – Second Byte | SPN_FMI | SPN_CONV | Not Defined

SAE J1939/71 Reference | | | 1214 | 1214
Scale
Offset
Data Range
Operating Range
Remarks | See parameter description below | FFh | | | See parameter description below | See parameter description below | FFFFh

Parameter | LAMPS_STATUS

Definition | Malfunction Indicator Lamp Status | Red Stop Lamp Status | Amber Warning Lamp Status | Protect Lamp Status
SAE J1939/71 Reference | 1213 | 624 | 624 | 987
Operating range | | 00b Lamp off 01b Lamp on | 00b Lamp off 01b Lamp on
Remarks | Not evaluated by the ECM – It has not to be evaluated by receiver(s) Not evaluated by ECM (00b) | | | Not evaluated by the ECM – It has not to be evaluated by receiver(s) Not evaluated by ECM (11b)

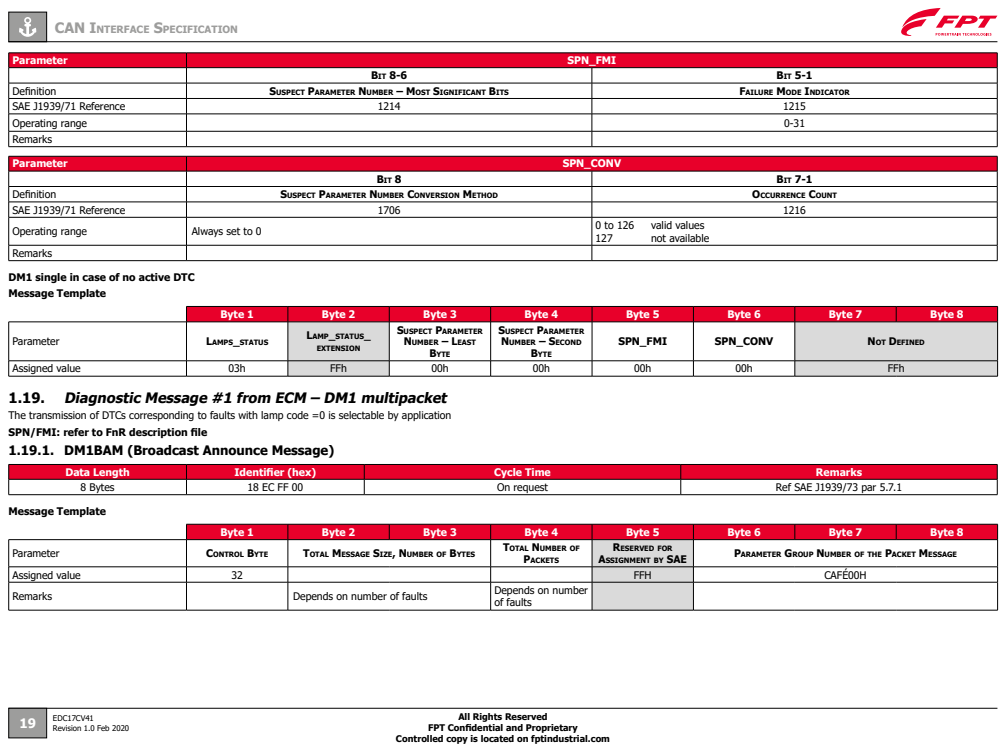
[picture p31: page 21]
Message Template

Parameter | SPN_FMI

Bit 8-6 | Bit 5-1

Definition | Suspect Parameter Number – Most Significant Bits | Failure Mode Indicator
SAE J1939/71 Reference | 1214 | 1215
Operating range | | 0-31
Remarks
Parameter | SPN_CONV

Bit 8 | Bit 7-1

Definition | Suspect Parameter Number Conversion Method | Occurrence Count
SAE J1939/71 Reference | 1706 | 1216
Operating range | Always set to 0 | 0 to 126 valid values 127 not available

DM1 single in case of no active DTC
Message Template

Byte 1 | Byte 2 | Byte 3 | Byte 4 | Byte 5 | Byte 6 | Byte 7 | Byte 8

Parameter | Lamps_status | Lamp_status_ extension | Suspect Parameter Number – Least Byte | Suspect Parameter Number – Second Byte | SPN_FMI | SPN_CONV | Not Defined

Assigned value | 03h | FFh | 00h | 00h | 00h | 00h | FFh

1.19. Diagnostic Message #1 from ECM – DM1 multipacket
The transmission of DTCs corresponding to faults with lamp code =0 is selectable by application
SPN/FMI: refer to FnR description file
1.19.1. DM1BAM (Broadcast Announce Message)

Data Length | Identifier (hex) | Cycle Time | Remarks
8 Bytes | 18 EC FF 00 | On request | Ref SAE J1939/73 par 5.7.1

Parameter | Control Byte | Total Message Size, Number of Bytes | Total Number of Packets | Reserved for Assignment by SAE | Parameter Group Number of the Packet Message
Assigned value | 32 | | | FFH | CAFÉ00H
Remarks | | Depends on number of faults | Depends on number of faults

## 1.19.2. DM1TP-DT (Transport Protocol – Data Transfer)

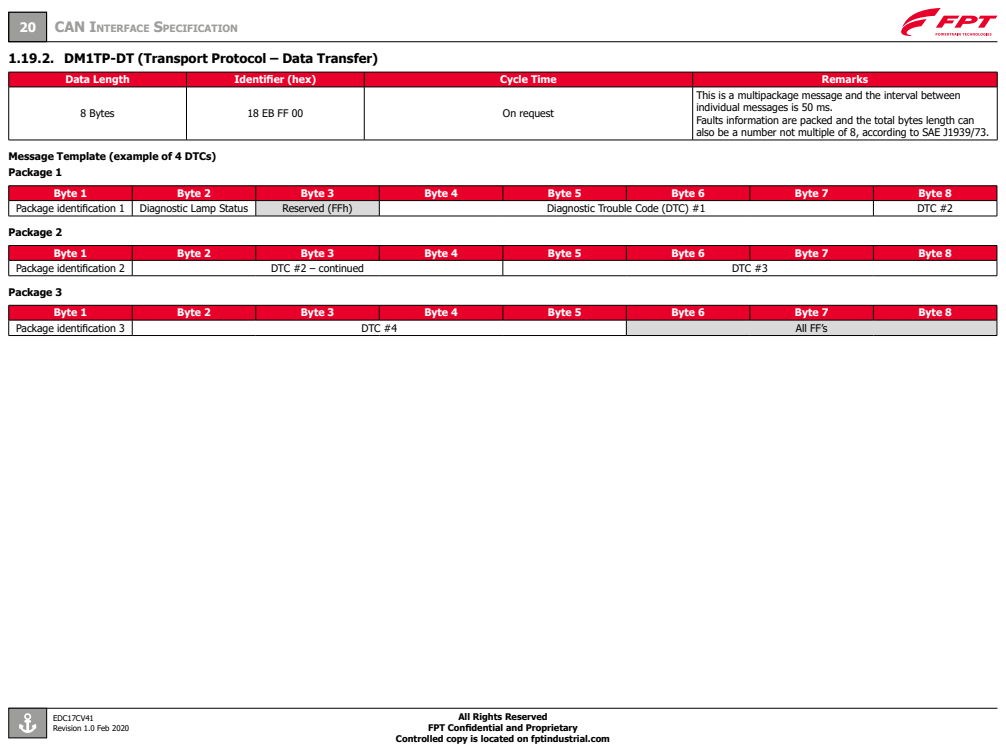
[picture p32: page 22]
Package 2; Package 3

20 CAN Interface Specification

Data Length | Identifier (hex) | Cycle Time | Remarks
8 Bytes | 18 EB FF 00 | On request | This is a multipackage message and the interval between individual messages is 50 ms. Faults information are packed and the total bytes length can also be a number not multiple of 8, according to SAE J1939/73.

Message Template (example of 4 DTCs)
Package 1

Byte 1 | Byte 2 | Byte 3 | Byte 4 | Byte 5 | Byte 6 | Byte 7 | Byte 8
Package identification 1 | Diagnostic Lamp Status | Reserved (FFh) | Diagnostic Trouble Code (DTC) #1 | | | | DTC #2

Package identification 2 | DTC #2 – continued | | | DTC #3

Package identification 3 | DTC #4 | | | | All FF’s
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
