usevolt/esb/sw/src/messages.c

/*
 * uw_messages.c
 *
 *  Created on: Feb 19, 2015
 *      Author: usenius
 */


#include "main.h"
#include "messages.h"
#include "can_esb.h"
#include "can_fsb.h"
#include "can_csb.h"
#include "pin_mappings.h"
#include <stdlib.h>
#include <stdio.h>
#include <string.h>
#include <uv_timer.h>
#include <uv_utilities.h>
#include <uv_eeprom.h>

extern dev_st dev;
#define this (&dev)




canopen_object_st obj_dict[] = {
		{
				.main_index = ESB_TOTAL_CURRENT_INDEX,
				.sub_index = ESB_TOTAL_CURRENT_SUBINDEX,
				.type = ESB_TOTAL_CURRENT_TYPE,
				.permissions = ESB_TOTAL_CURRENT_PERMISSIONS,
				.data_ptr = &this->total_current
		},
		{
				.main_index = ESB_RPM_REQ_INDEX,
				.sub_index = ESB_RPM_REQ_SUBINDEX,
				.type = ESB_RPM_REQ_TYPE,
				.permissions = ESB_RPM_REQ_PERMISSIONS,
				.data_ptr = &this->engine_rpm_req
		},
		{
				.main_index = ESB_GLOW_STATUS_INDEX,
				.sub_index = ESB_GLOW_STATUS_SUBINDEX,
				.type = ESB_GLOW_STATUS_TYPE,
				.permissions = ESB_GLOW_STATUS_PERMISSIONS,
				.data_ptr = &this->glow.state
		},
		{
				.main_index = ESB_GLOW_CURRENT_INDEX,
				.sub_index = ESB_GLOW_CURRENT_SUBINDEX,
				.type = ESB_GLOW_CURRENT_TYPE,
				.permissions = ESB_GLOW_CURRENT_PERMISSIONS,
				.data_ptr = &this->glow.current
		},
		{
				.main_index = ESB_STARTER_STATUS_INDEX,
				.sub_index = ESB_STARTER_STATUS_SUBINDEX,
				.type = ESB_STARTER_STATUS_TYPE,
				.permissions = ESB_STARTER_STATUS_PERMISSIONS,
				.data_ptr = &this->starter.state
		},
		{
				.main_index = ESB_STARTER_CURRENT_INDEX,
				.sub_index = ESB_STARTER_CURRENT_SUBINDEX,
				.type = ESB_STARTER_CURRENT_TYPE,
				.permissions = ESB_STARTER_CURRENT_PERMISSIONS,
				.data_ptr = &this->starter.current
		},
		{
				.main_index = ESB_AC_STATUS_INDEX,
				.sub_index = ESB_AC_STATUS_SUBINDEX,
				.type = ESB_AC_STATUS_TYPE,
				.permissions = ESB_AC_STATUS_PERMISSIONS,
				.data_ptr = &this->ac.state
		},
		{
				.main_index = ESB_AC_CURRENT_INDEX,
				.sub_index = ESB_AC_CURRENT_SUBINDEX,
				.type = ESB_AC_CURRENT_TYPE,
				.permissions = ESB_AC_CURRENT_PERMISSIONS,
				.data_ptr = &this->ac.current
		},
		{
				.main_index = ESB_ENGINE_START_STATUS_INDEX,
				.sub_index = ESB_ENGINE_START_STATUS_SUBINDEX,
				.type = ESB_ENGINE_START_STATUS_TYPE,
				.permissions = ESB_ENGINE_START_STATUS_PERMISSIONS,
				.data_ptr = &this->engine_start.state
		},
		{
				.main_index = ESB_ENGINE_START_CURRENT_INDEX,
				.sub_index = ESB_ENGINE_START_CURRENT_SUBINDEX,
				.type = ESB_ENGINE_START_CURRENT_TYPE,
				.permissions = ESB_ENGINE_START_CURRENT_PERMISSIONS,
				.data_ptr = &this->engine_start.current
		},
		{
				.main_index = ESB_ENGINE_IG_STATUS_INDEX,
				.sub_index = ESB_ENGINE_IG_STATUS_SUBINDEX,
				.type = ESB_ENGINE_IG_STATUS_TYPE,
				.permissions = ESB_ENGINE_IG_STATUS_PERMISSIONS,
				.data_ptr = &this->engine_ig.state
		},
		{
				.main_index = ESB_ENGINE_IG_CURRENT_INDEX,
				.sub_index = ESB_ENGINE_IG_CURRENT_SUBINDEX,
				.type = ESB_ENGINE_IG_CURRENT_TYPE,
				.permissions = ESB_ENGINE_IG_CURRENT_PERMISSIONS,
				.data_ptr = &this->engine_ig.current
		},
		{
				.main_index = ESB_ENGINE_MAIN_STATUS_INDEX,
				.sub_index = ESB_ENGINE_MAIN_STATUS_SUBINDEX,
				.type = ESB_ENGINE_MAIN_STATUS_TYPE,
				.permissions = ESB_ENGINE_MAIN_STATUS_PERMISSIONS,
				.data_ptr = &this->engine_main.state
		},
		{
				.main_index = ESB_ENGINE_MAIN_CURRENT_INDEX,
				.sub_index = ESB_ENGINE_MAIN_CURRENT_SUBINDEX,
				.type = ESB_ENGINE_MAIN_CURRENT_TYPE,
				.permissions = ESB_ENGINE_MAIN_CURRENT_PERMISSIONS,
				.data_ptr = &this->engine_main.current
		},
		{
				.main_index = ESB_ENGINE_STOP_CAUSE_INDEX,
				.sub_index = ESB_ENGINE_STOP_CAUSE_SUBINDEX,
				.type = ESB_ENGINE_STOP_CAUSE_TYPE,
				.permissions = ESB_ENGINE_STOP_CAUSE_PERMISSIONS,
				.data_ptr = &this->engine_stop_cause
		},
		{
				.main_index = ESB_ENGINE_MAIN_INPUT_INDEX,
				.sub_index = ESB_ENGINE_MAIN_INPUT_SUBINDEX,
				.type = ESB_ENGINE_MAIN_INPUT_TYPE,
				.permissions = ESB_ENGINE_MAIN_INPUT_PERMISSIONS,
				.data_ptr = &this->engine_main_relay_i
		},
		{
				.main_index = ESB_ENGINE_START_INPUT_INDEX,
				.sub_index = ESB_ENGINE_START_INPUT_SUBINDEX,
				.type = ESB_ENGINE_START_INPUT_TYPE,
				.permissions = ESB_ENGINE_START_INPUT_PERMISSIONS,
				.data_ptr = &this->starter_relay_i
		},
		{
				.main_index = ESB_IDLE_RPM_INDEX,
				.sub_index = ESB_IDLE_RPM_SUBINDEX,
				.type = ESB_IDLE_RPM_TYPE,
				.permissions = ESB_IDLE_RPM_PERMISSIONS,
				.data_ptr = &this->idle_rpm
		},
		{
				.main_index = ESB_WORK_RPM_INDEX,
				.sub_index = ESB_WORK_RPM_SUBINDEX,
				.type = ESB_WORK_RPM_TYPE,
				.permissions = ESB_WORK_RPM_PERMISSIONS,
				.data_ptr = &this->work_rpm
		},
		{
				.main_index = ESB_DRIVE_RPM_INDEX,
				.sub_index = ESB_DRIVE_RPM_SUBINDEX,
				.type = ESB_DRIVE_RPM_TYPE,
				.permissions = ESB_DRIVE_RPM_PERMISSIONS,
				.data_ptr = &this->drive_rpm
		},
		{
				.main_index = ESB_PUMP_STATUS_INDEX,
				.sub_index = ESB_PUMP_STATUS_SUBINDEX,
				.type = ESB_PUMP_STATUS_TYPE,
				.permissions = ESB_PUMP_STATUS_PERMISSIONS,
				.data_ptr = &this->pump.super.state
		},
		{
				.main_index = ESB_PUMP_CURRENT_INDEX,
				.sub_index = ESB_PUMP_CURRENT_SUBINDEX,
				.type = ESB_PUMP_CURRENT_TYPE,
				.permissions = ESB_PUMP_CURRENT_PERMISSIONS,
				.data_ptr = &this->pump.super.current
		},
		{
				.main_index = ESB_OILCOOLER_STATUS_INDEX,
				.sub_index = ESB_OILCOOLER_STATUS_SUBINDEX,
				.type = ESB_OILCOOLER_STATUS_TYPE,
				.permissions = ESB_OILCOOLER_STATUS_PERMISSIONS,
				.data_ptr = &this->oilcooler.state
		},
		{
				.main_index = ESB_OILCOOLER_CURRENT_INDEX,
				.sub_index = ESB_OILCOOLER_CURRENT_SUBINDEX,
				.type = ESB_OILCOOLER_CURRENT_TYPE,
				.permissions = ESB_OILCOOLER_CURRENT_PERMISSIONS,
				.data_ptr = &this->oilcooler.current
		},
		{
				.main_index = ESB_OILCOOLER_TRIGGER_INDEX,
				.sub_index = ESB_OILCOOLER_TRIGGER_SUBINDEX,
				.type = ESB_OILCOOLER_TRIGGER_TYPE,
				.permissions = ESB_OILCOOLER_TRIGGER_PERMISSIONS,
				.data_ptr = &this->oilcooler_trigger_temp
		},
		{
				.main_index = ESB_RADIATOR_STATUS_INDEX,
				.sub_index = ESB_RADIATOR_STATUS_SUBINDEX,
				.type = ESB_RADIATOR_STATUS_TYPE,
				.permissions = ESB_RADIATOR_STATUS_PERMISSIONS,
				.data_ptr = &this->radiator.state
		},
		{
				.main_index = ESB_RADIATOR_CURRENT_INDEX,
				.sub_index = ESB_RADIATOR_CURRENT_SUBINDEX,
				.type = ESB_RADIATOR_CURRENT_TYPE,
				.permissions = ESB_RADIATOR_CURRENT_PERMISSIONS,
				.data_ptr = &this->radiator.current
		},
		{
				.main_index = ESB_RADIATOR_ENABLED_INDEX,
				.sub_index = ESB_RADIATOR_ENABLED__SUBINDEX,
				.type = ESB_RADIATOR_ENABLED_TYPE,
				.permissions = ESB_RADIATOR_ENABLED_PERMISSIONS,
				.data_ptr = &this->radiator_enabled
		},
		{
				.main_index = ESB_RPM_INDEX,
				.sub_index = ESB_RPM_SUBINDEX,
				.type = ESB_RPM_TYPE,
				.permissions = ESB_RPM_PERMISSIONS,
				.data_ptr = &this->alt_p_rpm
		},
		{
				.main_index = ESB_ALT_L_INDEX,
				.sub_index = ESB_ALT_L_SUBINDEX,
				.type = ESB_ALT_L_TYPE,
				.permissions = ESB_ALT_L_PERMISSIONS,
				.data_ptr = &this->alt_l
		},
		{
				.main_index = ESB_MOTOR_WATER_TEMP_INDEX,
				.sub_index = ESB_MOTOR_WATER_TEMP_SUBINDEX,
				.type = ESB_MOTOR_WATER_TEMP_TYPE,
				.permissions = ESB_MOTOR_WATER_TEMP_PERMISSIONS,
				.data_ptr = &this->motor_water_temp
		},
		{
				.main_index = ESB_MOTOR_OIL_PRESS_INDEX,
				.sub_index = ESB_MOTOR_OIL_PRESS_SUBINDEX,
				.type = ESB_MOTOR_OIL_PRESS_TYPE,
				.permissions = ESB_MOTOR_OIL_PRESS_PERMISSIONS,
				.data_ptr = &this->motor_oil_press
		},
		{
				.main_index = ESB_MOTOR_TEMP_INDEX,
				.sub_index = ESB_MOTOR_TEMP_SUBINDEX,
				.type = ESB_MOTOR_TEMP_TYPE,
				.permissions = ESB_MOTOR_TEMP_PERMISSIONS,
				.data_ptr = &this->motor_temp_value
		},
		{
				.main_index = ESB_OIL_TEMP_INDEX,
				.sub_index = ESB_OIL_TEMP_SUBINDEX,
				.type = ESB_OIL_TEMP_TYPE,
				.permissions = ESB_OIL_TEMP_PERMISSIONS,
				.data_ptr = &this->oil_temp_value
		},
		{
				.main_index = ESB_OIL_LEVEL_INDEX,
				.sub_index = ESB_OIL_LEVEL_SUBINDEX,
				.type = ESB_OIL_LEVEL_TYPE,
				.permissions = ESB_OIL_LEVEL_PERMISSIONS,
				.data_ptr = &this->oil_level_value
		},
		{
				.main_index = ESB_VDD_INDEX,
				.sub_index = ESB_VDD_SUBINDEX,
				.type = ESB_VDD_TYPE,
				.permissions = ESB_VDD_PERMISSIONS,
				.data_ptr = &this->vdd
		},
		{
				.main_index = ESB_HOUR_INDEX,
				.sub_index = ESB_HOUR_SUBINDEX,
				.type = ESB_HOUR_TYPE,
				.permissions = ESB_HOUR_PERMISSIONS,
				.data_ptr = &this->hour_counter
		},
		{
				.main_index = ESB_DITHER_FREQ_INDEX,
				.sub_index = ESB_DITHER_FREQ_SUBINDEX,
				.type = ESB_DITHER_FREQ_TYPE,
				.permissions = ESB_DITHER_FREQ_PERMISSIONS,
				.data_ptr = &this->dither_freq
		},
		{
				.main_index = ESB_DITHER_AMPL_INDEX,
				.sub_index = ESB_DITHER_AMPL_SUBINDEX,
				.type = ESB_DITHER_AMPL_TYPE,
				.permissions = ESB_DITHER_AMPL_PERMISSIONS,
				.data_ptr = &this->dither_ampl
		},
		{
				.main_index = ESB_ENGINE_POWER_USAGE_INDEX,
				.sub_index = ESB_ENGINE_POWER_USAGE_SUBINDEX,
				.type = ESB_ENGINE_POWER_USAGE_TYPE,
				.permissions = ESB_ENGINE_POWER_USAGE_PERMISSIONS,
				.data_ptr = &this->engine_power_usage
		},
		{
				.main_index = ESB_PUMP_ANGLE_INDEX,
				.sub_index = ESB_PUMP_ANGLE_SUBINDEX,
				.type = ESB_PUMP_ANGLE_TYPE,
				.permissions = ESB_PUMP_ANGLE_PERMISSIONS,
				.data_ptr = &this->pwr.pump_angle
		},
		{
				.main_index = ESB_ENGINE_POWER_ENABLE_INDEX,
				.sub_index = ESB_ENGINE_POWER_ENABLE_SUBINDEX,
				.type = ESB_ENGINE_POWER_ENABLE_TYPE,
				.permissions = ESB_ENGINE_POWER_ENABLE_PERMISSIONS,
				.data_ptr = &this->pump_enabled
		},
		{
				.main_index = ESB_PARTICULATEFILTER_STATUS_INDEX,
				.sub_index = ESB_PARTICULATEFILTER_STATUS_SUBINDEX,
				.type = ESB_PARTICULATEFILTER_STATUS_TYPE,
				.permissions = ESB_PARTICULATEFILTER_PERMISSIONS,
				.data_ptr = &this->partfilter_status
		},
		{
				.main_index = ESB_REGEN_FORCE_INDEX,
				.sub_index = ESB_REGEN_FORCE_SUBINDEX,
				.type = ESB_REGEN_FORCE_TYPE,
				.permissions = ESB_REGEN_FORCE_PERMISSIONS,
				.data_ptr = &this->regen_force
		},

		// other node's parameters
		{
				.main_index = ESB_FSB_IGNKEY_INDEX,
				.sub_index = ESB_FSB_IGNKEY_SUBINDEX,
				.type = FSB_IGNKEY_TYPE,
				.permissions = ESB_FSB_IGNKEY_PERMISSIONS,
				.data_ptr = &this->fsb.ignkey_state
		},
		{
				.main_index = ESB_FSB_EMCY_INDEX,
				.sub_index = ESB_FSB_EMCY_SUBINDEX,
				.type = FSB_EMCY_TYPE,
				.permissions = ESB_FSB_EMCY_PERMISSIONS,
				.data_ptr = &this->fsb.emcy
		},
		{
				.main_index = ESB_CSB_COOLER_P_INDEX,
				.sub_index = ESB_CSB_COOLER_P_SUBINDEX,
				.type = FSB_EMCY_TYPE,
				.permissions = ESB_CSB_COOLER_P_PERMISSIONS,
				.data_ptr = &this->csb.ac_req
		},
		{
				.main_index = ESB_HCU_INDEX_OFFSET + HCU_PRESSURE_INDEX,
				.sub_index = HCU_PRESSURE_SUBINDEX,
				.type = HCU_PRESSURE_TYPE,
				.permissions = HCU_PRESSURE_PERMISSIONS,
				.data_ptr = &this->hcu.hydr_pressure
		},
		{
				.main_index = ESB_HCU_INDEX_OFFSET + HCU_WORK_ACTIVE_INDEX,
				.sub_index = HCU_WORK_ACTIVE_SUBINDEX,
				.type = HCU_WORK_ACTIVE_TYPE,
				.permissions = CANOPEN_WO,
				.data_ptr = &this->hcu.work_active
		},
		{
				.main_index = ESB_CCU_INDEX_OFFSET + CCU_WORK_ACTIVE_INDEX,
				.sub_index = CCU_WORK_ACTIVE_SUBINDEX,
				.type = CCU_WORK_ACTIVE_TYPE,
				.permissions = CANOPEN_WO,
				.data_ptr = &this->ccu.work_active
		},
		{
				.main_index = ESB_CCU_INDEX_OFFSET + CCU_DRIVE_ACTIVE_INDEX,
				.sub_index = CCU_DRIVE_ACTIVE_SUBINDEX,
				.type = CCU_DRIVE_ACTIVE_TYPE,
				.permissions = CANOPEN_WO,
				.data_ptr = &this->ccu.drive_active
		},
};

int obj_dict_len() {
	return sizeof(obj_dict) / sizeof(canopen_object_st);
}


void engine_callb(void *me, unsigned int cmd, unsigned int args, argument_st *argv);
void pump_callb(void *me, unsigned int cmd, unsigned int args, argument_st *argv);
void clear_callb(void *me, unsigned int cmd, unsigned int args, argument_st *argv);
void oilc_callb(void *me, unsigned int cmd, unsigned int args, argument_st *argv);
void ac_callb(void *me, unsigned int cmd, unsigned int args, argument_st *argv);
void enable_callb(void *me, unsigned int cmd, unsigned int args, argument_st *argv);
void rad_callb(void *me, unsigned int cmd, unsigned int args, argument_st *argv);
void hour_callb(void *me, unsigned int cmd, unsigned int args, argument_st *argv);



const uv_command_st terminal_commands[] = {
		{
				.id = CMD_STAT,
				.str = "stat",
				.instructions = "Displays the system status information.\n"
						"Usage: stat",
				.callback = &stat_callb
		},
		{
				.id = CMD_ENGINE,
				.str = "engine",
				.instructions = "Simulates the ignition key positions.\n"
						"0: power off\n"
						"1: power on\n"
						"2: Glow Plugs on\n"
						"3: starter on\n"
						"Usage: engine (0/1/2/3)",
				.callback = &engine_callb
		},
		{
				.id = CMD_PUMP,
				.str = "pump",
				.instructions = "Sets the hydraulic pump output parameters\n"
						"Usage: pump (enabled/\"usage\") (usage)",
				.callback = &pump_callb
		},
		{
				.id = CMD_OILC,
				.str = "oilc",
				.instructions = "Sets the oil cooler trigger temperature.\n"
						"Usage: oilc <-127...127>",
				.callback = &oilc_callb
		},
		{
				.id = CMD_AC,
				.str = "ac",
				.instructions = "Forces the air conditioner compressor on or off.\n"
						"Usage: ac <1/0>",
				.callback = &ac_callb
		},
		{
				.id = CMD_ENABLE,
				.str = "enable",
				.instructions = "Enabled or disables output modules. Overrides module functionality.\n"
						"Usage: enable <\"pump\"/\"glow\"/\"starter\"/\"altig\""
						"/\"oilc\"/\"estart\"/\"ac\"/\"radiator\"> <1/0>",
				.callback = &enable_callb
		},
		{
				.id = CMD_HOUR,
				.str = "hour",
				.instructions = "",
				.callback = &hour_callb
		}
};




unsigned int commands_size(void) {
	return sizeof(terminal_commands) / sizeof(uv_command_st);
}




static void stat_output(uv_output_st *output, bool enabled, const char *output_name) {
	printf("%s state: %u, enabled: %u, current: %u mA\n",
			output_name, uv_output_get_state(output), enabled, uv_output_get_current(output));
}


void stat_callb(void* me, unsigned int cmd, unsigned int args, argument_st *argv) {
	printf("SYSTEM STATUS:\n");
	printf("Total current: %u mA\n", (unsigned int) this->total_current);
	printf("Motor temperature: %i C, state: %u, adc: 0x%x\n"
			"Hydraulic oil temperature: %i C, state: %u, adc: 0x%x\n"
			"Oil level: %u %%, state: %u\n",
			uv_sensor_get_value(&this->motor_temp),
			uv_sensor_get_state(&this->motor_temp),
			uv_adc_read(MOTOR_TEMP_AIN),
			uv_sensor_get_value(&this->oil_temp),
			uv_sensor_get_state(&this->oil_temp),
			uv_adc_read(OIL_TEMP_AIN),
			uv_sensor_get_value(&this->oil_level),
			uv_sensor_get_state(&this->oil_level));
	printf("Rpm: %u\nAlt L: %u\n, Motor Water Temp: %u\nMotor Oil Pressure: %u\n",
			this->alt_p_rpm,
			this->alt_l,
			this->motor_water_temp,
			this->motor_oil_press);
	printf("engine req: %u rpm\n"
			"    particulate filter status: 0x%x\n"
			"    particulate filter inhibit: 0x%x\n",
			this->engine_rpm_req,
			this->partfilter_status,
			this->partfilter_inhibits);
	stat_output(&this->glow, this->glow_enabled, "Glow Plugs");
	stat_output(&this->starter, this->starter_enabled, "Starter");
	stat_output(&this->ac, this->ac_enabled, "AC compressor");
	stat_output((uv_output_st *) &this->pump, this->pump_enabled, "Hydr Pump");
	printf("Engine power usage: %u, enabled: %u\n", this->engine_power_usage, this->pump_enabled);
	stat_output(&this->oilcooler, this->oilcooler_enabled, "OilC");
	stat_output(&this->radiator, this->radiator_enabled, "Radiator");
	printf("Vdd: %u mV 0x%x\n", this->vdd, uv_adc_read(VDD_SENSE_AIN));
	printf("stop cause: %u\n", this->engine_stop_cause);
	printf("Hours: %u\n", (unsigned int) this->hour_counter);
	printf("FSB ignkey state: %u, emcy: %u\n", this->fsb.ignkey_state, this->fsb.emcy);
	printf("CSB ac req: %u\n", this->csb.ac_req);
	printf("HCU hydr pressure: %i\n", (int) this->hcu.hydr_pressure);

}



void engine_callb(void *me, unsigned int cmd, unsigned int args, argument_st *argv) {
	if ((args == 1) &&
			(argv[0].type == ARG_INTEGER)) {
		printf("engine state: ");
		if (argv[0].number == 0) {
			this->fsb.ignkey_state = FSB_IGNKEY_STATE_OFF;
			printf("OFF\n");
		}
		else if (argv[0].number == 1) {
			this->fsb.ignkey_state = FSB_IGNKEY_STATE_ON;
			printf("ON\n");
		}
		else if (argv[0].number == 2) {
			this->fsb.ignkey_state = FSB_IGNKEY_STATE_PREHEAT;
			printf("PREHEAT\n");
		}
		else if (argv[0].number == 3) {
			this->fsb.ignkey_state = FSB_IGNKEY_STATE_START;
			printf("START\n");
		}
		else {

		}
	}
}



void pump_callb(void *me, unsigned int cmd, unsigned int args, argument_st *argv) {
	if (args) {
		if (argv[0].type == ARG_STRING && args > 1) {
			if (strcmp(argv[0].str, "usage") == 0) {
				this->engine_power_usage = argv[1].number;
			}
		}
		else {

		}
	}
	printf("Engine power usage enabled: %u, usage: %u\n",
			this->pump_enabled, this->engine_power_usage);
}



void oilc_callb(void *me, unsigned int cmd, unsigned int args, argument_st *argv) {
	if (args) {
		this->oilcooler_trigger_temp = argv[0].number;
	}
	printf("Oil cooler trigger temp: %i\n", this->oilcooler_trigger_temp);
}



void ac_callb(void *me, unsigned int cmd, unsigned int args, argument_st *argv) {
	if (args) {
		this->ac_override = argv[0].number;
	}
	printf("ac override: %u\n", this->ac_override);
}


void enable_callb(void *me, unsigned int cmd, unsigned int args, argument_st *argv) {
	if (args >= 2 &&
			(argv[0].type == ARG_STRING) &&
			(argv[1].type == ARG_INTEGER)) {
		char *str = argv[0].str;
		int value = argv[1].number ? true : false;
		if (strcmp(str, "starter") == 0) {
			this->starter_enabled = value;
		}
		else if (strcmp(str, "glow") == 0) {
			this->glow_enabled = value;
		}
		else if (strcmp(str, "ac") == 0) {
			this->ac_enabled = value;
		}
		else if (strcmp(str, "oilc") == 0) {
			this->oilcooler_enabled = value;
		}
		else if (strcmp(str, "pump") == 0) {
			this->pump_enabled = value;
		}
		else if (strcmp(str, "radiator") == 0) {
			this->radiator_enabled = value;
		}
		else if (strcmp(str, "all") == 0) {
			this->starter_enabled = value;
			this->glow_enabled = value;
			this->ac_enabled = value;
			this->oilcooler_enabled = value;
			this->pump_enabled = value;
		}
		else {
			printf("Unknown module '%s'\n", str);
		}
	}
	printf("Module enable states:\n"
			"   Starter: %u\n"
			"   Glow: %u\n"
			"   AC: %u\n"
			"   Oil Cooler: %u\n"
			"   Pump: %u\n"
			"   Radiator: %u\n",
			this->starter_enabled,
			this->glow_enabled,
			this->ac_enabled,
			this->oilcooler_enabled,
			this->pump_enabled,
			this->radiator_enabled);
}


void hour_callb(void *me, unsigned int cmd, unsigned int args, argument_st *argv) {
	if (args >= 2 &&
			argv[0].type == ARG_STRING &&
			argv[1].type == ARG_INTEGER &&
			strcmp(argv[0].str, "uw") == 0) {
		this->hour_counter = argv[1].number;
		uv_eeprom_write(&this->hour_counter, sizeof(this->hour_counter), HOUR_ADDR);
		printf("%u written.\n", this->hour_counter);
	}
	else {
		printf("Hours: %u h\n", this->hour_counter);
	}
}
