usevolt/esb/(commit log)

2017-06-13 separated version control from msb
    [LT1161.sch, PT100.sch, currentSense.sch, lpc1549.sch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]
2017-06-13 added 1k pull down resistors to mosfet gates
    [LT1161.sch, currentSense.sch, msb.kicad_pcb]
2017-06-16 trying to get software running - CAN bus problems
    [msb.sch]
2017-06-28 pcb first revision created, ready to order
    [LT1161.sch, PT100.sch, currentSense.sch, currentSense2.sch, esb.FCStd, esb.kicad_pcb, esb.sch, lpc1549.sch]
2017-07-03 first revision ordered from itead
    [esb.kicad_pcb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]
2017-08-03 hw modifications from first version
    [PT100.sch, currentSense.sch, esb.kicad_pcb, lt1161_1.sch, optocoupler.sch, pwr_supply_sheet.sch]
2017-08-30 hw small modifications
    [esb.FCStd]
2017-09-05 analog shortcircuit protection added to LT1161
    [esb.kicad_pcb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]
2017-09-12 tag 3.0.0 schematic drawing started
    [PT100.sch, currentSense.sch, currentSense2.sch, esb.kicad_pcb, esb.sch, lpc1549.sch, lt1161_1.sch, lt1161_2.sch]
2017-09-12 added binary and build files to gitignore
    [PT100.sch, currentSense.sch, currentSense2.sch, esb.kicad_pcb, esb.sch, lpc1549.sch, lt1161_1.sch, lt1161_2.sch]
2017-10-08 3.0.0 ready to order
    [PT100.sch, _saved_esb.sch, _saved_lpc1549.sch, _saved_lt1161_1.sch, currentSense.sch, currentSense2.sch, currentSense3.sch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]
2017-10-08 3.0.0 order changed to 3.1.0
    - optocpouplers removed from digital inputs
    [PT100.sch, _saved_esb.sch, _saved_lpc1549.sch, _saved_lt1161_1.sch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]
2017-10-20 sensor warning emcy message sent only once per event
2017-10-20 sensor emcy bugfixes, vdd low warning added
    [main.c, main.h]
2017-10-24 4.0.0 ordered from itead
    [PT100.sch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]
2017-11-14 4.1.0 hw created, not yet ordered
    [PT100.sch, esb.kicad_pcb, esb.sch, levelsensor.sch, lpc1549.sch, lt1161_1.sch, lt1161_2.sch, optocoupler.sch]
2017-11-17 implemnting pump propo output
    [esb.kicad_pcb, pwr_supply_sheet.sch]
2017-11-18 4.2.0 created, with working propo solenoid pump driver
    [PT100.sch, esb.kicad_pcb, esb.sch, lpc1549.sch, lt1161_1.sch, lt1161_2.sch, optocoupler.sch, pwr_supply_sheet.sch]
2017-11-18 4.2.0 gerber created for seeed studios
    [esb-B.Cu.gbl, esb-B.Mask.gbs, esb-B.SilkS.gbo, esb-Edge.Cuts.gm1, esb-F.Cu.gtl, esb-F.Mask.gts, esb-F.SilkS.gto, esb.drl]
2017-11-20 hw bugs fixed from 4.2.0 revsion
    [PT100.sch, bts6133d.sch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]
2017-12-08 flyback diodes added for solenoid outputs
    [PT100.sch, bts6133d.sch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]
2017-12-14 drawing hw revision 4.4, not yet ordered. High power mosfets changed to STSemiconductor mosfets
    [esb.kicad_pcb, esb.sch, vn5e010ah.sch]
2017-12-19 hw 4.4 ordered from seeed
    [PT100.sch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]
2018-01-31 Hydraulic controller unit version control created
    [LT1161.sch, PT100.sch, currentSense.sch, currentSense2.sch, currentSense3.sch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]
2018-02-05 working revision in FM_6.6.1
    [PT100.sch, esb.kicad_pcb, esb.sch, lpc1549.sch, optocoupler.sch, pwr_supply_sheet.sch, vn5e010ah.sch, vnd5050.sch]
2018-03-12 starting to redraw the pcb as a smaller (icu enclosure)
    [PT100-2018-03-08-21-40-49.sch, PT100.sch, esb-2018-03-08-21-40-49.sch, esb.sch, lpc1549-2018-03-08-21-40-49.sch, lpc1549.sch, optocoupler-2018-03-08-21-40-49.sch, optocoupler.sch]
2018-04-07 pump solenoid output working
    [esb.kicad_pcb, esb.sch, lpc1549.sch, pwr_supply_sheet.sch]
2018-04-14 motor & oil temp cantype = signed8
2018-04-23 temperature sensor fault state bugfix
    temperature sensor was set to can bus as 8 bit integer, but it was declare as 16 bit. now this is fixed.
    Oil cooler is also disabled if oil temperature sensor is faulty
    [main.c]
2018-05-07 alternator fault disabled pump power limitation
    [PT100.sch, esb.sch, lpc1549.sch, optocoupler.sch, pwr_supply_sheet.sch, vn5e010ah.sch, vn5e010ah_double.sch, vnd5050.sch]
2018-06-09 motor temp warning limit set to 96 deg
2018-06-25 drawing new version of esb, not finished
    [PT100.sch, esb.kicad_pcb, esb.sch, lpc1549.sch, optocoupler.sch, pwr_supply_sheet.sch, vn5e010ah.sch, vn5e010ah_double.sch]
2018-06-28 motor & oil temp warning values increased
2018-07-29 sensor hysteresis' increased
2018-08-05 sensor module moved to uv_hal, fuel level removed
2018-08-05 bug fix: sensor values in obj dict match the variable length (8-bit)
    [main.c, main.h, messages.c]
2018-08-07 hw version 5.0.0, for hcu enclosure
    [PT100.sch, esb.FCStd, esb.kicad_pcb, esb.sch, lpc1549.sch, optocoupler.sch, pwr_supply_sheet.sch, vn5e010ah.sch]
2018-08-07 bug fixes when updating uv_hal
    [main.c, main.h]
2018-09-09 with renewed solenoid output module
2018-09-24 pulldown resistors added to power outputs
    [esb.kicad_pcb, esb.sch, vn5e010ah.sch, vn5e010ah_double.sch]
2018-09-24 sense protection diodes replaced to zeners
    [esb.kicad_pcb, vn5e010ah.sch, vn5e010ah_double.sch, vnd5050.sch]
2018-09-24 bottom silkscreen for pcb 5.1
    [esb.kicad_pcb]
2018-10-04 hw 5.1 created
    [esb-B.Cu.gbl, esb-B.Paste.gbp, esb-B.SilkS.gbo, esb-Edge.Cuts.gm1, esb-F.Cu.gtl, esb-F.Paste.gtp, esb-F.SilkS.gto, esb-NPTH.drl]
2018-12-19 hw 5.1.0 pin mappings updated
2018-12-29 radiator fet added to pcb, but not yet ready
    [PT100.sch, esb.kicad_pcb, esb.sch, lpc1549.sch, optocoupler.sch, pwr_supply_sheet.sch, vn5e010ah.sch, vn5e010ah_double.sch]
2019-01-21 ce mark modified
    [esb.kicad_pcb]
2019-01-30 pcb 5.2.0 ready for order, with radiator power output
    [esb-B.Cu.gbl, esb-B.Mask.gbs, esb-B.Paste.gbp, esb-B.SilkS.gbo, esb-Edge.Cuts.gm1, esb-F.Cu.gtl, esb-F.Mask.gts, esb-F.Paste.gtp]
2019-02-25 PWM_LIMIT_DIVIDER adjusted
2019-03-19 pin mappings for 5.2.0, with radiator output
2019-05-10 stat command prints also temp sensor adc values
2019-06-05 pump resonance decreased, temp sensor resonance fixed
    [main.c]
2019-07-28 radiator max current increased to 40A, works with 4 VN5E010
2019-07-29 radiator works depending on the motor temperature
2019-09-10 pump solenoid output step function is now in it's own thread!
2019-11-02 median measurement implemented for temperature sensors
2020-02-05 reorganazing pcb with 4 fets on radiator
    [esb.kicad_pcb, esb.sch, vn5e010ah.sch, vn5e010ah_triple.sch]
2020-04-29 pcb redrawn with all components on top side
    [esb-B.Cu.gbl, esb-B.Mask.gbs, esb-B.SilkS.gbo, esb-Edge.Cuts.gm1, esb-F.Cu.gtl, esb-F.Mask.gts, esb-F.Paste.gtp, esb-F.SilkS.gto]
2020-05-14 cdd adc value added to stat
2020-07-20 reverse protection diodes removed
    [esb-B.Cu.gbl, esb-B.Mask.gbs, esb-B.SilkS.gbo, esb-Edge.Cuts.gm1, esb-F.Cu.gtl, esb-F.Mask.gts, esb-F.Paste.gtp, esb-F.SilkS.gto]
2020-12-12 implementing stage5
2020-12-28 forwarder valve wirings renamed and modified. steer valves are as subindexes to right hand wires
2021-10-06 hour reset command added
    [messages.c, messages.h]
